Jzhoou/Lymphedema-Massager/模型/第二版建模sw文件/按摩环内装配体.SLDASM

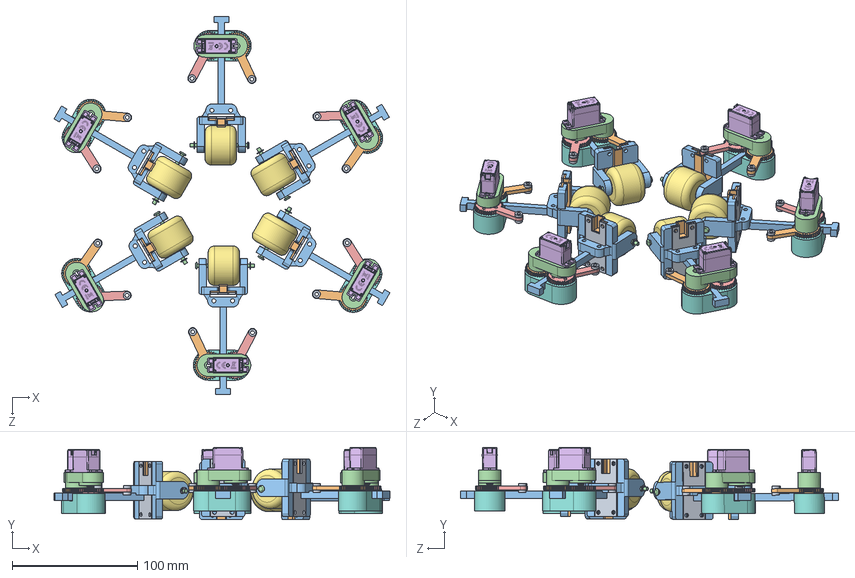
[picture p1: CAD file, 2026-10-14]
模型/第二版建模sw文件/按摩环内装配体.SLDASM
268.4 x 57.9 x 302.2 mm
DS1202三维图 x 6
主动齿轮 x 6
齿轮座盖1.0 x 6
按摩头连接件1.0 x 6
被动齿轮 x 6
滚动轴承 x 24
舵机盖 x 6
按摩头2.0 x 6
卡簧 x 6
微型轴承 x 12
轴销 x 6
柱塞 x 6
下盖sw x 6
上盖sw x 6
