Jzhoou/Lymphedema-Massager/模型/第二版建模sw文件/收纳盒.SLDASM

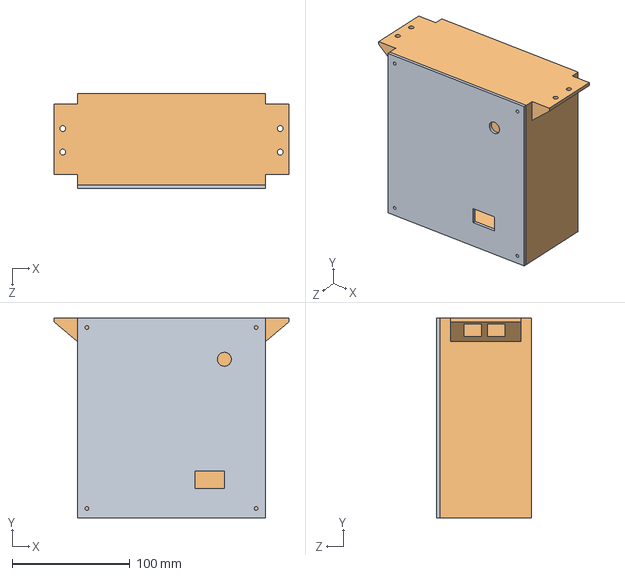
[picture p2: CAD file, 2026-10-14]
模型/第二版建模sw文件/收纳盒.SLDASM
200.0 x 170.0 x 81.0 mm
外壳1
外壳2
