Jzhoou/Lymphedema-Massager/模型/第二版建模sw文件/压力/压力传感器.SLDASM

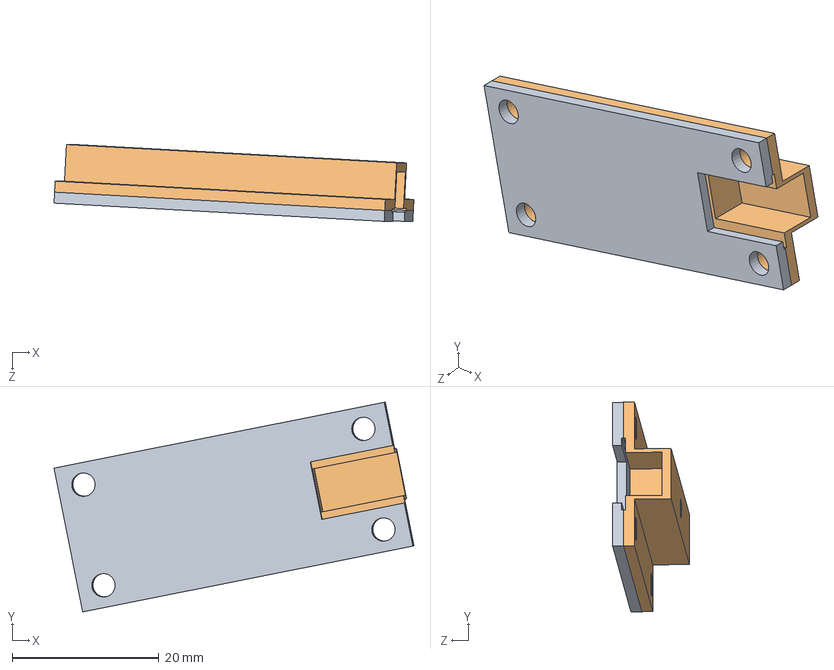
[picture p3: CAD file, 2026-10-14]
模型/第二版建模sw文件/压力/压力传感器.SLDASM
49.1 x 28.6 x 10.5 mm
柱塞
下盖sw
上盖sw
