Jzhoou/Lymphedema-Massager/模型/第二版建模sw文件/总装配体.SLDASM

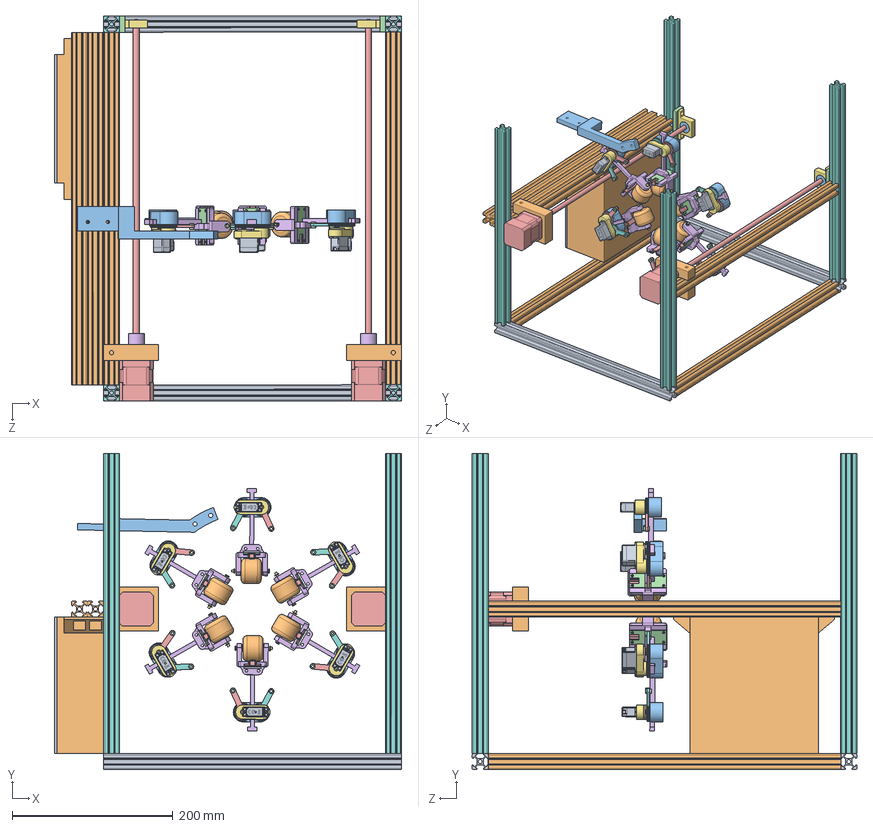
[picture p4: CAD file, 2026-10-14]
模型/第二版建模sw文件/总装配体.SLDASM
432.1 x 394.0 x 479.0 mm
铝型材43.9cm x 6
铝型材37.1cm x 2
铝型材37.4cm x 4
丝杆末端固定件 x 2
联轴器 x 2
丝杆电机 x 2
丝杆固定件座垫 x 2
丝杆末端固定件内端 x 2
电机固定件3.0 x 3
DS1202三维图 x 6
主动齿轮 x 6
齿轮座盖1.0 x 6
按摩头连接件1.0 x 6
被动齿轮 x 6
滚动轴承 x 24
舵机盖 x 6
按摩头2.0 x 6
卡簧 x 6
微型轴承 x 12
轴销 x 6
柱塞 x 6
下盖sw x 6
上盖sw x 6
工作台
外壳1
外壳2
