Jzhoou/Lymphedema-Massager/模型/第二版建模sw文件/外壳装配体.SLDASM

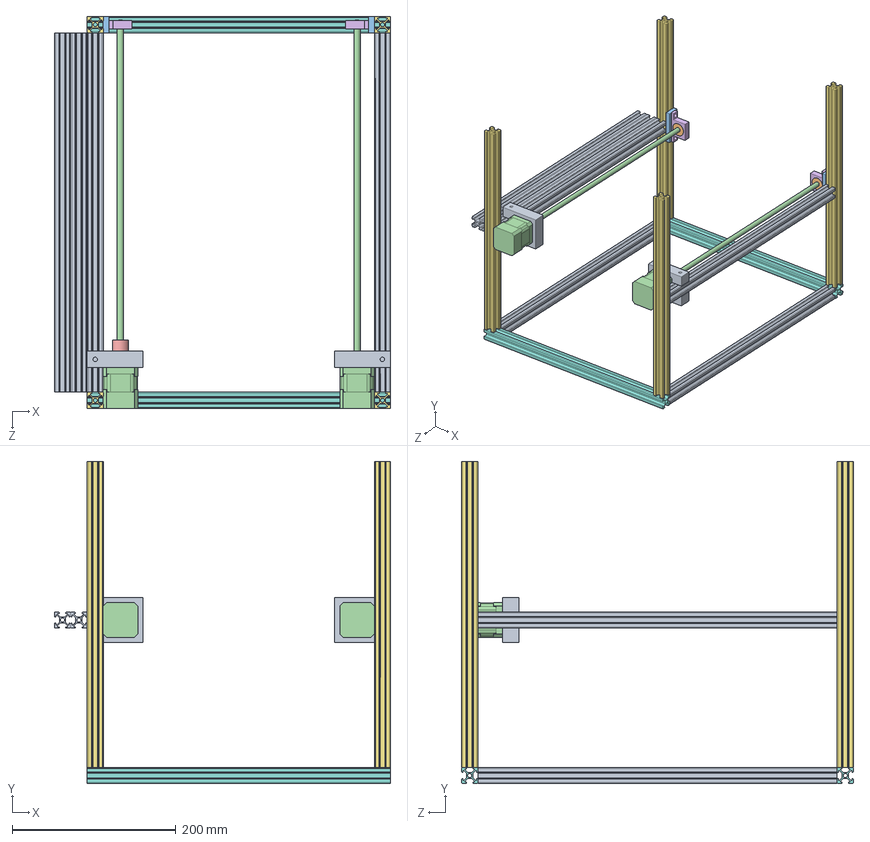
[picture p5: CAD file, 2026-10-14]
模型/第二版建模sw文件/外壳装配体.SLDASM
411.1 x 394.0 x 479.0 mm
铝型材43.9cm x 6
铝型材37.1cm x 2
铝型材37.4cm x 4
丝杆末端固定件 x 2
联轴器
丝杆电机 x 2
丝杆固定件座垫 x 2
丝杆末端固定件内端 x 2
电机固定件3.0 x 2
