Jzhoou/Lymphedema-Massager/模型/第二版建模sw文件/舵机按摩头装配体.SLDASM

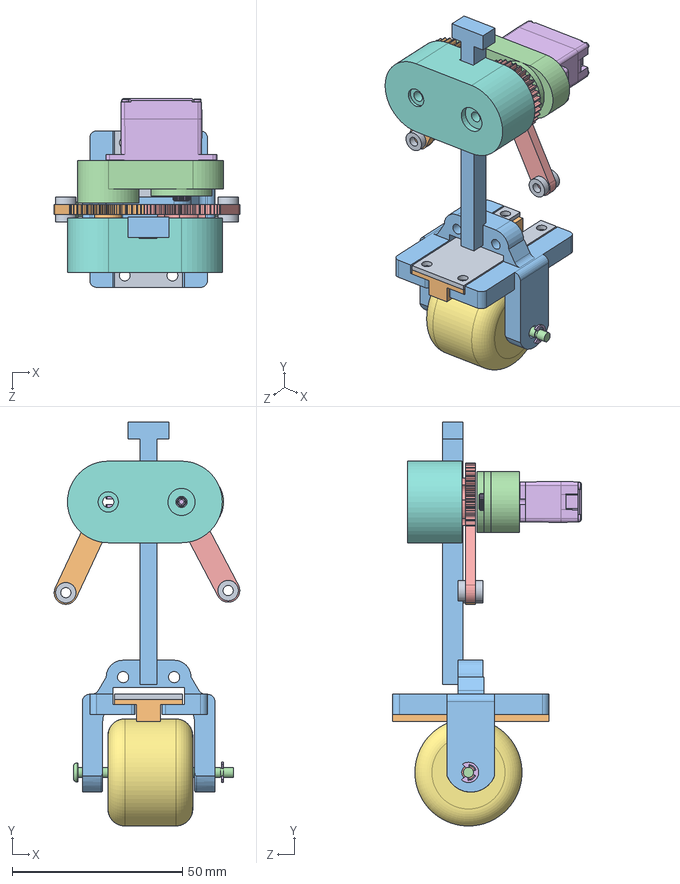
[picture p6: CAD file, 2026-10-14]
模型/第二版建模sw文件/舵机按摩头装配体.SLDASM
54.6 x 118.7 x 55.5 mm
DS1202三维图
主动齿轮
齿轮座盖1.0
按摩头连接件1.0
被动齿轮
滚动轴承 x 4
舵机盖
按摩头2.0
卡簧
微型轴承 x 2
轴销
柱塞
下盖sw
上盖sw
