Jzhoou/Lymphedema-Massager/上位机/measurement-perception-master/Upcomputer.UI/Resources/arm.STL

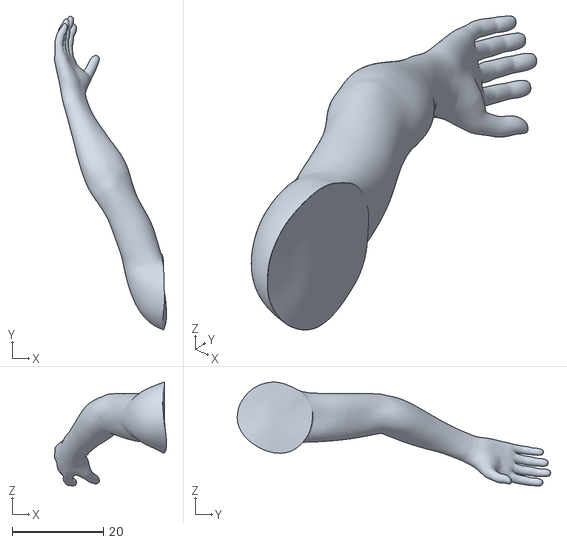
[picture p7: CAD file, 2026-06-20]
上位机/measurement-perception-master/Upcomputer.UI/Resources/arm.STL
24.5 x 68.7 x 22.7
