Jzhoou/Lymphedema-Massager/模型/第二版建模sw文件/压力/shuangzi2.stp

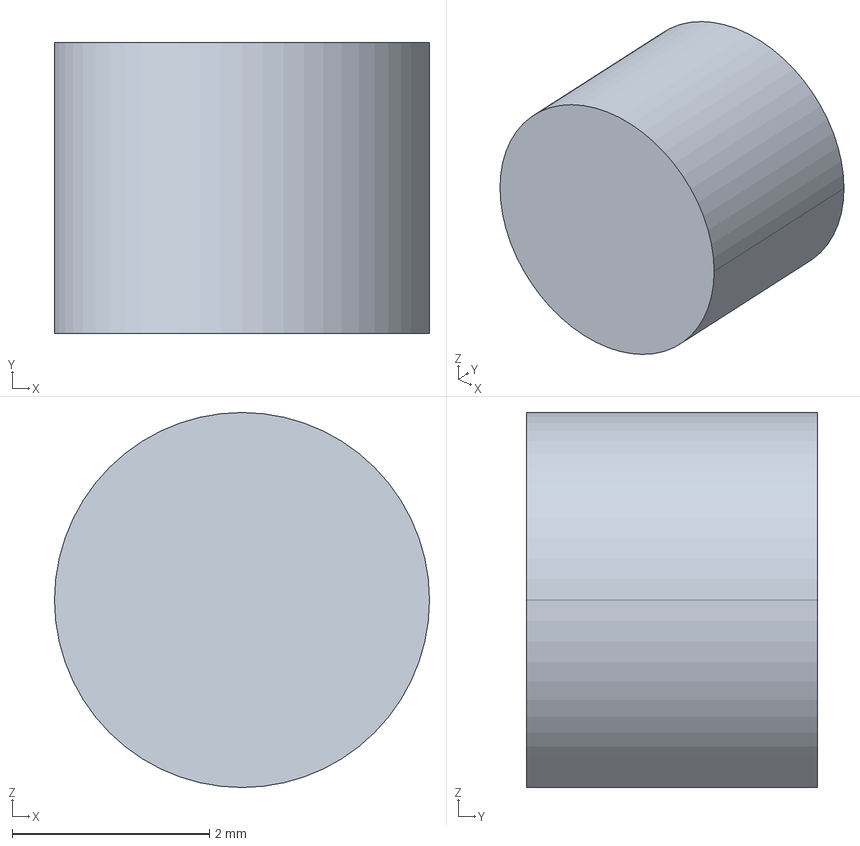
[picture p8: CAD file, 2026-10-14]
模型/第二版建模sw文件/压力/shuangzi2.stp
3.80 x 2.95 x 3.80 mm
