Jzhoou/Lymphedema-Massager/模型/第二版建模sw文件/压力/下盖.SLDPRT

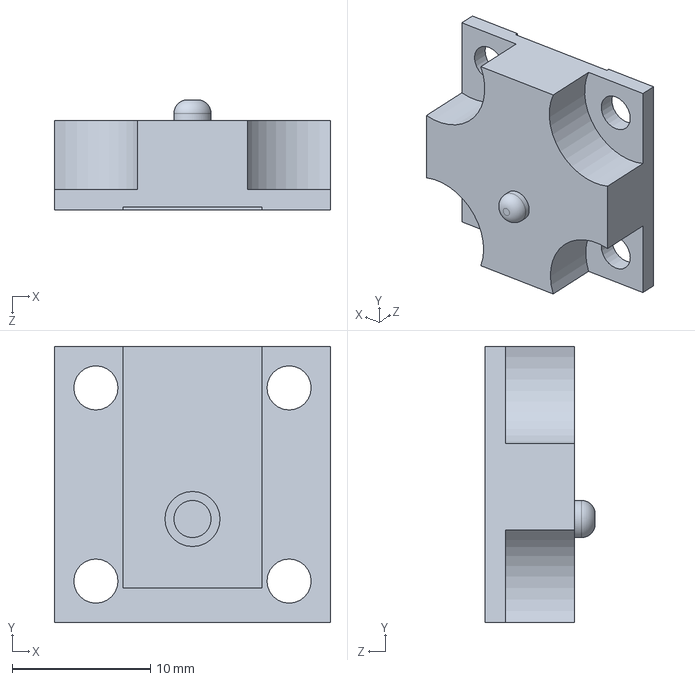
[picture p9: CAD file, 2026-10-14]
模型/第二版建模sw文件/压力/下盖.SLDPRT
20.0 x 20.0 x 8.00 mm
