Jzhoou/Lymphedema-Massager/模型/第二版建模sw文件/微型轴承.SLDPRT

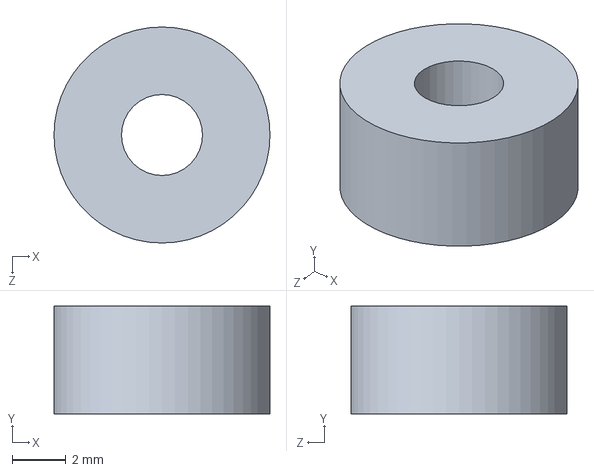
[picture p10: CAD file, 2026-10-14]
模型/第二版建模sw文件/微型轴承.SLDPRT
8.00 x 4.00 x 8.00 mm
