Jzhoou/Lymphedema-Massager/模型/第二版建模sw文件/丝杆固定件座垫.SLDPRT

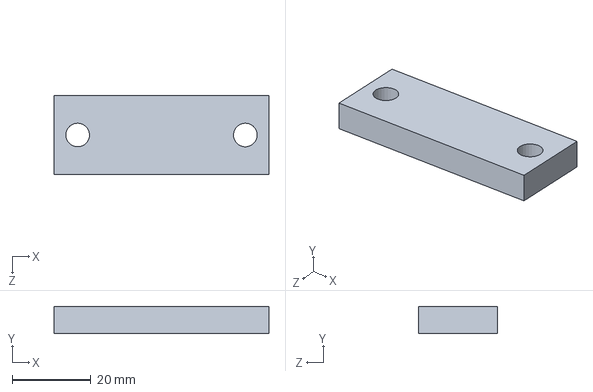
[picture p11: CAD file, 2026-10-14]
模型/第二版建模sw文件/丝杆固定件座垫.SLDPRT
54.5 x 6.85 x 20.0 mm
