Jzhoou/Lymphedema-Massager/模型/第二版建模sw文件/压力/上盖2.SLDPRT

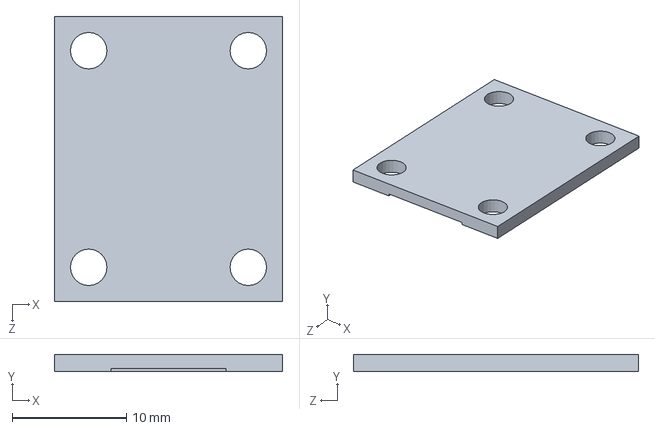
[picture p12: CAD file, 2026-10-14]
模型/第二版建模sw文件/压力/上盖2.SLDPRT
20.0 x 1.50 x 25.0 mm
