Jzhoou/Lymphedema-Massager/模型/第二版建模sw文件/压力/下盖sw.SLDPRT

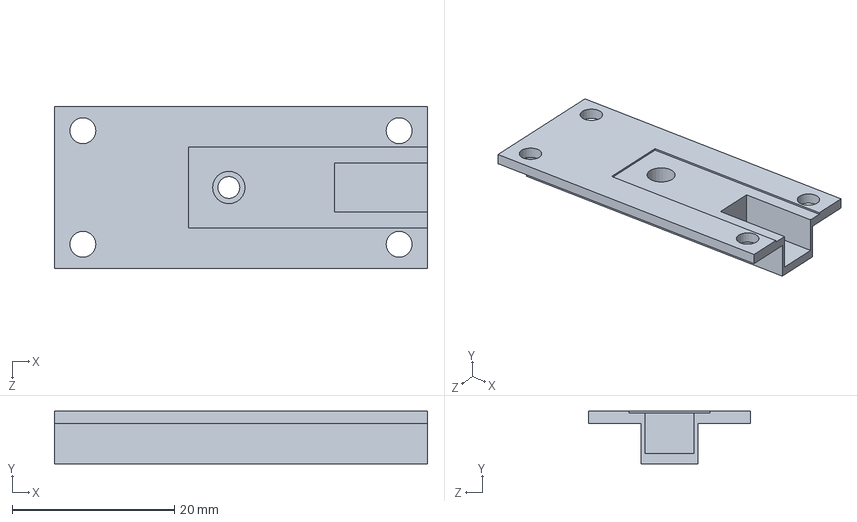
[picture p13: CAD file, 2026-10-14]
模型/第二版建模sw文件/压力/下盖sw.SLDPRT
46.0 x 6.50 x 20.0 mm
