Jzhoou/Lymphedema-Massager/模型/第二版建模sw文件/压力/下盖1.SLDPRT

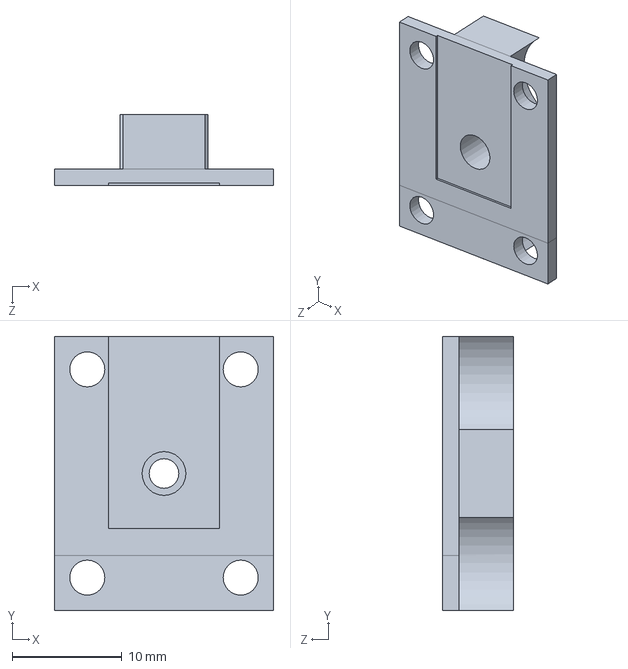
[picture p14: CAD file, 2026-10-14]
模型/第二版建模sw文件/压力/下盖1.SLDPRT
20.0 x 25.0 x 6.50 mm
