Jzhoou/Lymphedema-Massager/模型/第二版建模sw文件/垫片.SLDPRT

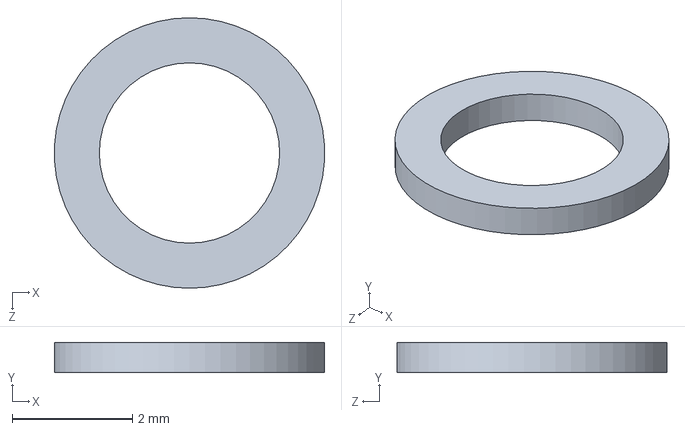
[picture p15: CAD file, 2026-10-14]
模型/第二版建模sw文件/垫片.SLDPRT
4.49 x 0.5 x 4.50 mm
