Jzhoou/Lymphedema-Massager/模型/第二版建模sw文件/按摩头打印版2.0凸.SLDPRT

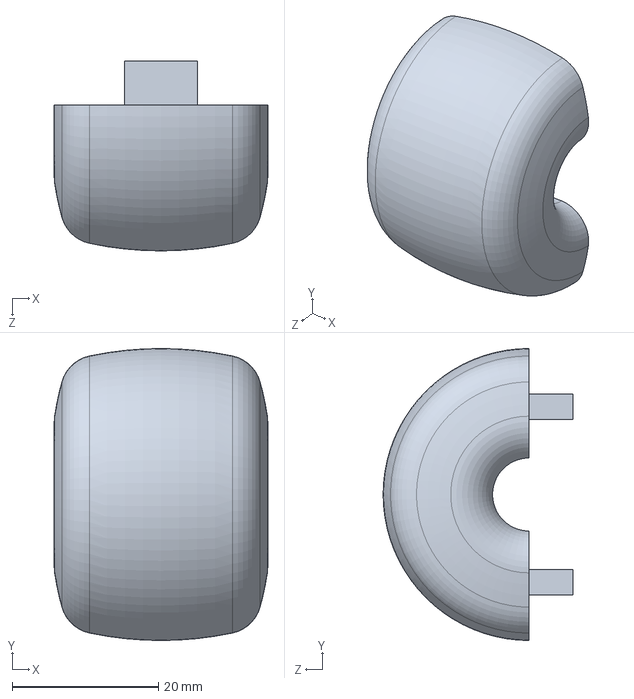
[picture p16: CAD file, 2026-10-14]
模型/第二版建模sw文件/按摩头打印版2.0凸.SLDPRT
29.3 x 40.0 x 26.0 mm
