Jzhoou/Lymphedema-Massager/模型/第二版建模sw文件/DS1202三维图.SLDPRT

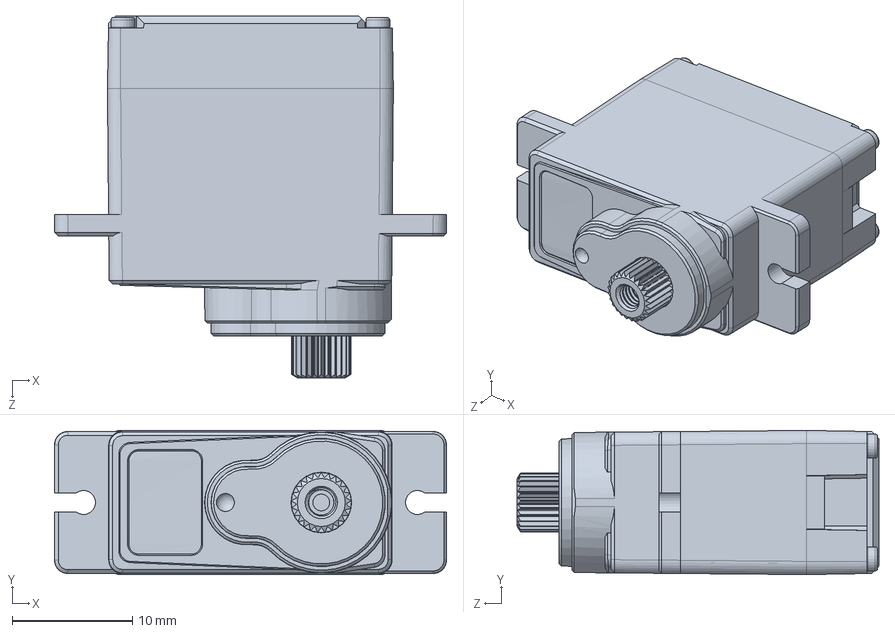
[picture p17: CAD file, 2026-10-14]
模型/第二版建模sw文件/DS1202三维图.SLDPRT
32.6 x 12.0 x 30.1 mm
