Jzhoou/Lymphedema-Massager/模型/第二版建模sw文件/压力/xiabufen4(1).stp

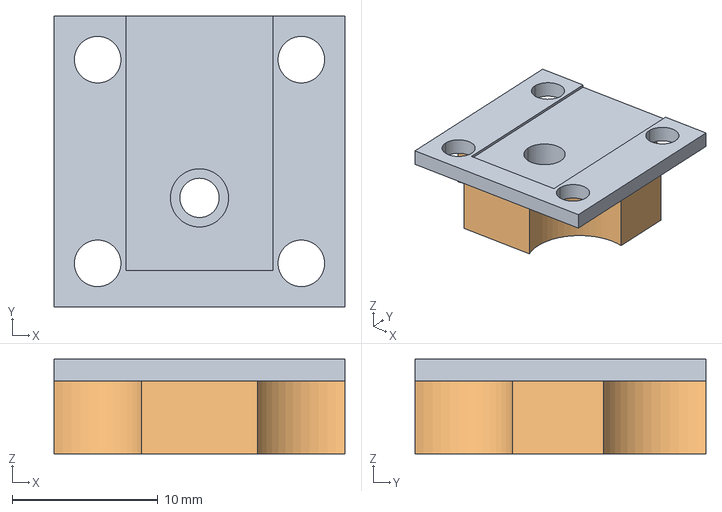
[picture p18: CAD file, 2026-10-14]
模型/第二版建模sw文件/压力/xiabufen4(1).stp
20.0 x 20.0 x 6.50 mm
