Jzhoou/Lymphedema-Massager/模型/第二版建模sw文件/按摩头2.0.SLDPRT

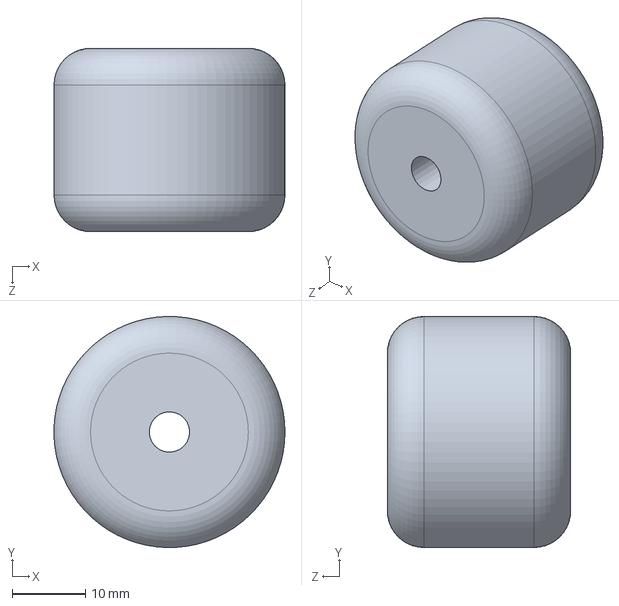
[picture p19: CAD file, 2026-10-14]
模型/第二版建模sw文件/按摩头2.0.SLDPRT
31.5 x 31.5 x 25.0 mm
