Jzhoou/Lymphedema-Massager/模型/第二版建模sw文件/舵机盖.SLDPRT

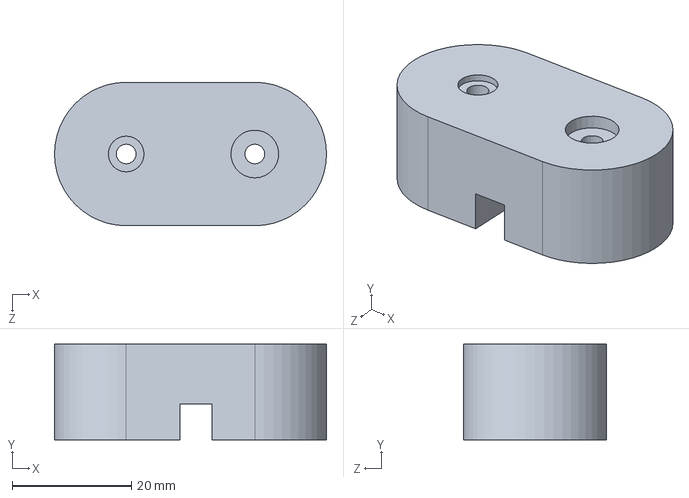
[picture p20: CAD file, 2026-10-14]
模型/第二版建模sw文件/舵机盖.SLDPRT
45.5 x 16.0 x 24.0 mm
