Jzhoou/Lymphedema-Massager/模型/第二版建模sw文件/压力/上盖sw.SLDPRT

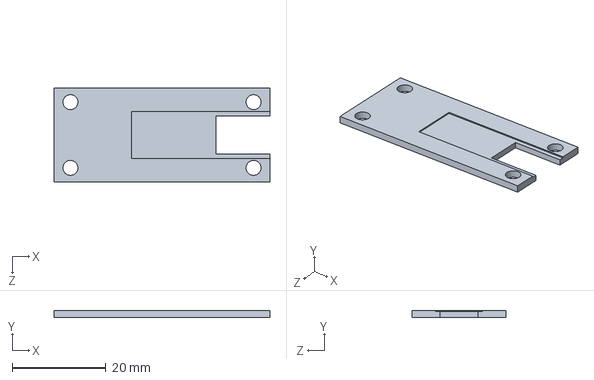
[picture p21: CAD file, 2026-10-14]
模型/第二版建模sw文件/压力/上盖sw.SLDPRT
46.0 x 1.50 x 20.0 mm
