Jzhoou/Lymphedema-Massager/模型/第二版建模sw文件/卡簧.SLDPRT

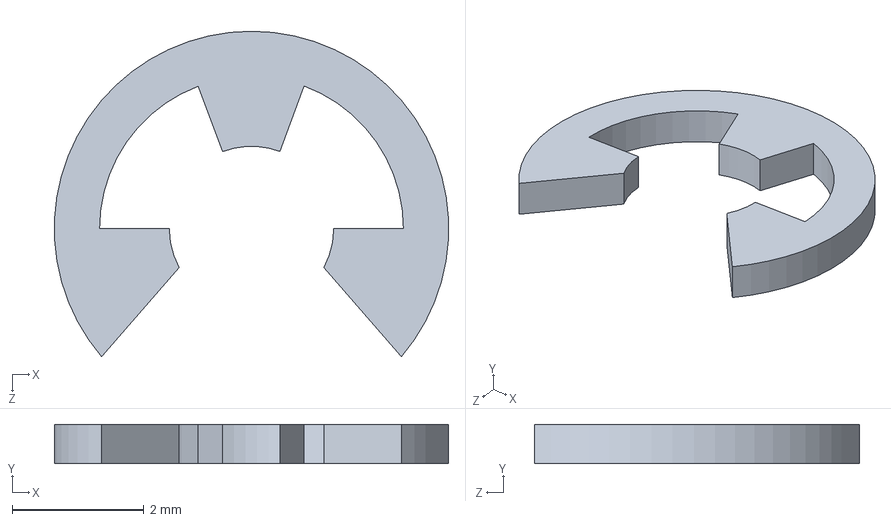
[picture p22: CAD file, 2026-10-14]
模型/第二版建模sw文件/卡簧.SLDPRT
5.99 x 0.6 x 4.95 mm
