Jzhoou/Lymphedema-Massager/模型/第二版建模sw文件/压力/柱塞sw.SLDPRT

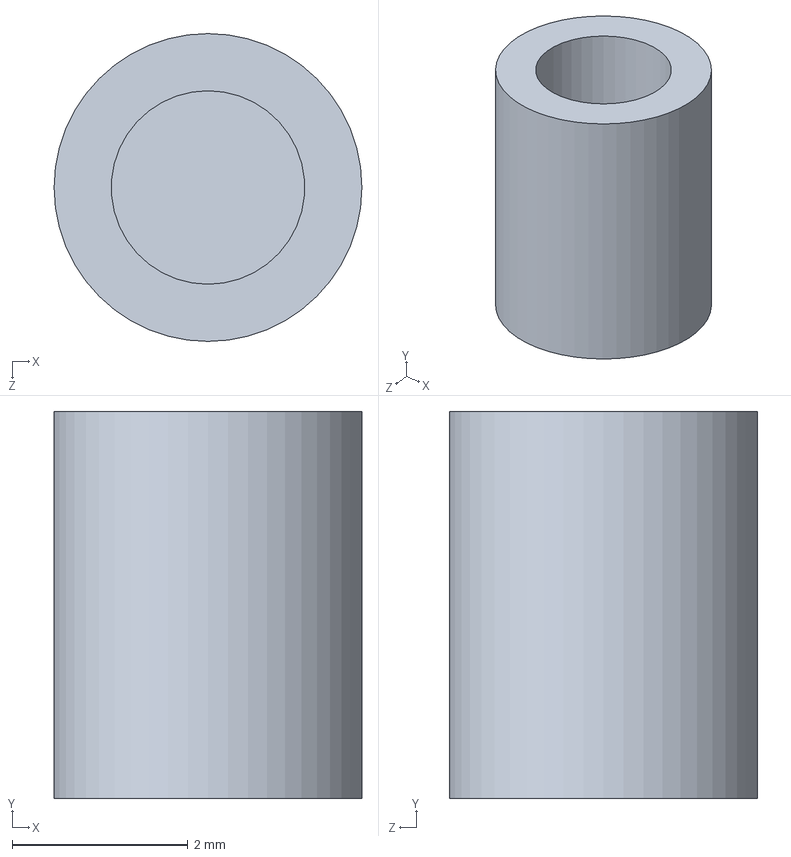
[picture p23: CAD file, 2026-10-14]
模型/第二版建模sw文件/压力/柱塞sw.SLDPRT
3.50 x 4.40 x 3.50 mm
