Jzhoou/Lymphedema-Massager/模型/第二版建模sw文件/压力/shangbufen.stp

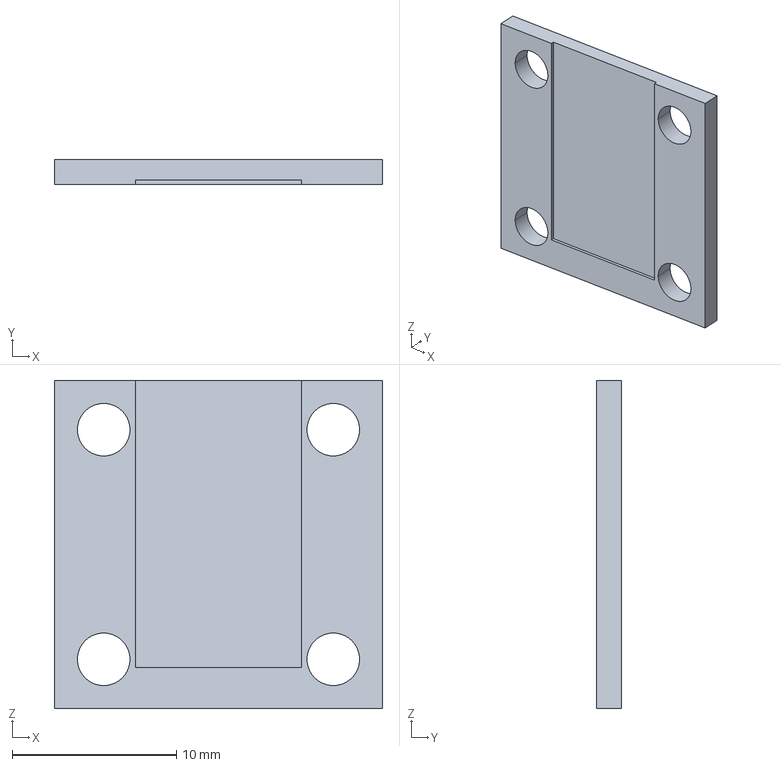
[picture p24: CAD file, 2026-10-14]
模型/第二版建模sw文件/压力/shangbufen.stp
20.0 x 1.50 x 20.0 mm
