Jzhoou/Lymphedema-Massager/模型/第二版建模sw文件/工作台.SLDPRT

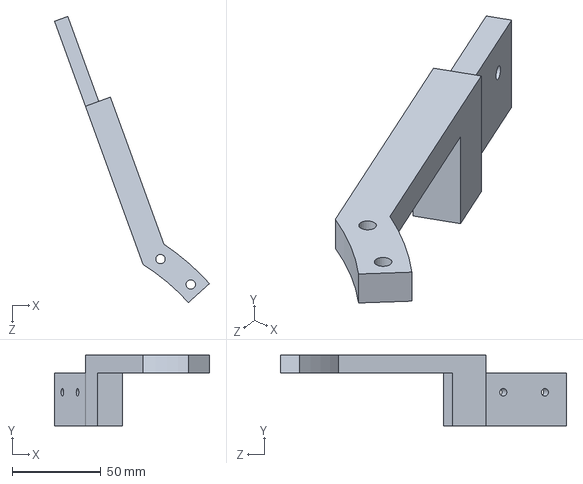
[picture p25: CAD file, 2026-10-14]
模型/第二版建模sw文件/工作台.SLDPRT
87.4 x 40.0 x 161.4 mm
