Jzhoou/Lymphedema-Massager/模型/第二版建模sw文件/铝型材37.1cm.SLDPRT

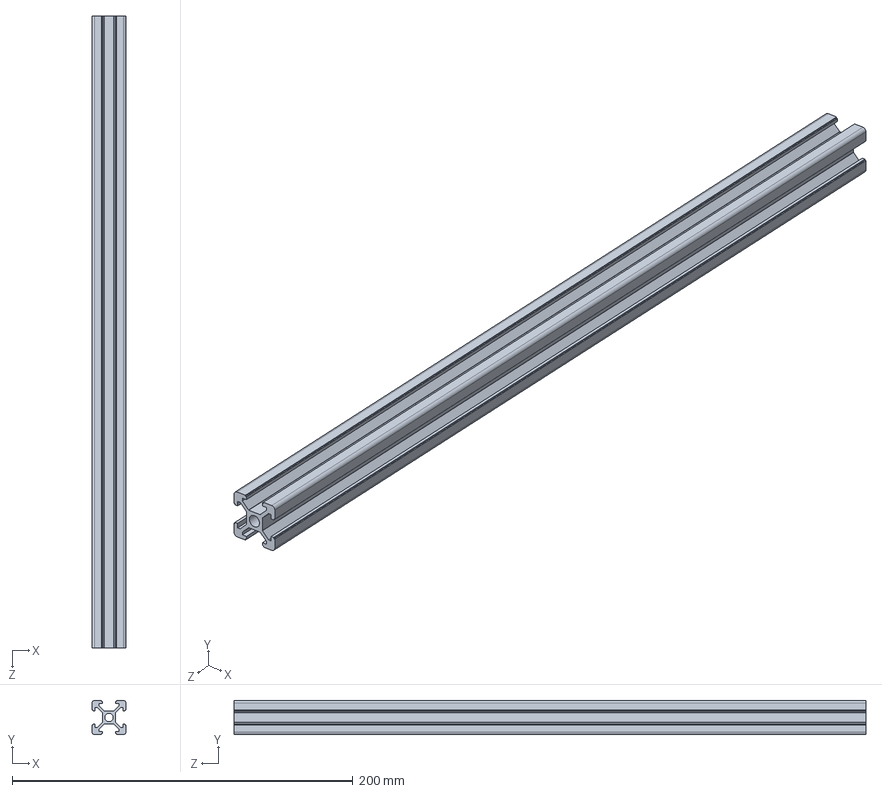
[picture p26: CAD file, 2026-10-14]
模型/第二版建模sw文件/铝型材37.1cm.SLDPRT
20.0 x 20.0 x 371.0 mm
