Jzhoou/Lymphedema-Massager/模型/第二版建模sw文件/压力/上盖.SLDPRT

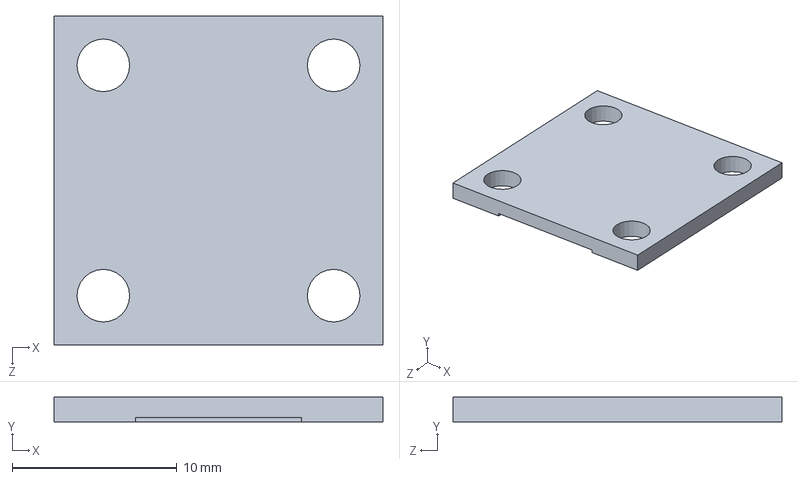
[picture p27: CAD file, 2026-10-14]
模型/第二版建模sw文件/压力/上盖.SLDPRT
20.0 x 1.50 x 20.0 mm
