Jzhoou/Lymphedema-Massager/模型/第二版建模sw文件/挡片2.SLDPRT

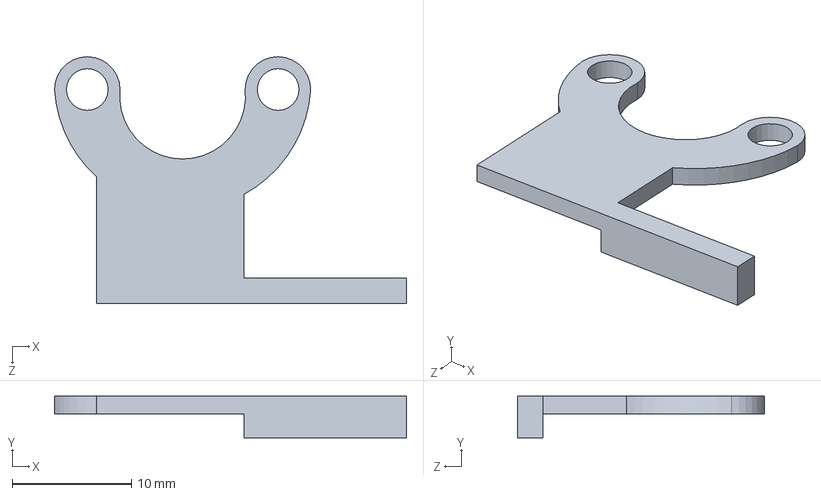
[picture p28: CAD file, 2026-10-14]
模型/第二版建模sw文件/挡片2.SLDPRT
29.5 x 3.50 x 20.7 mm
