Jzhoou/Lymphedema-Massager/模型/第二版建模sw文件/丝杆末端固定件.SLDPRT

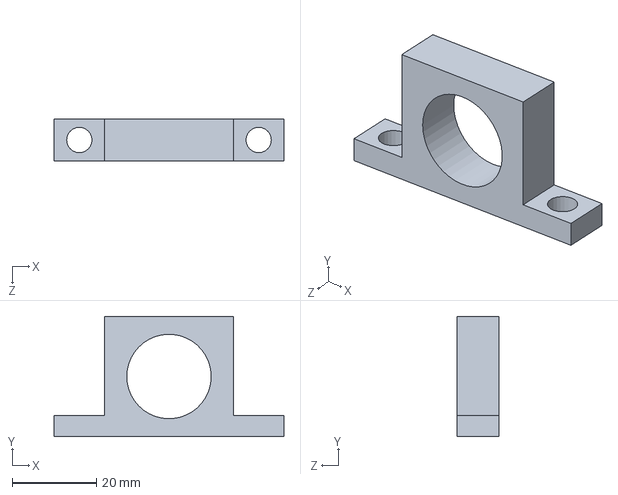
[picture p29: CAD file, 2026-10-14]
模型/第二版建模sw文件/丝杆末端固定件.SLDPRT
54.5 x 28.5 x 10.0 mm
