Jzhoou/Lymphedema-Massager/模型/第二版建模sw文件/电机固定件3.0.SLDPRT

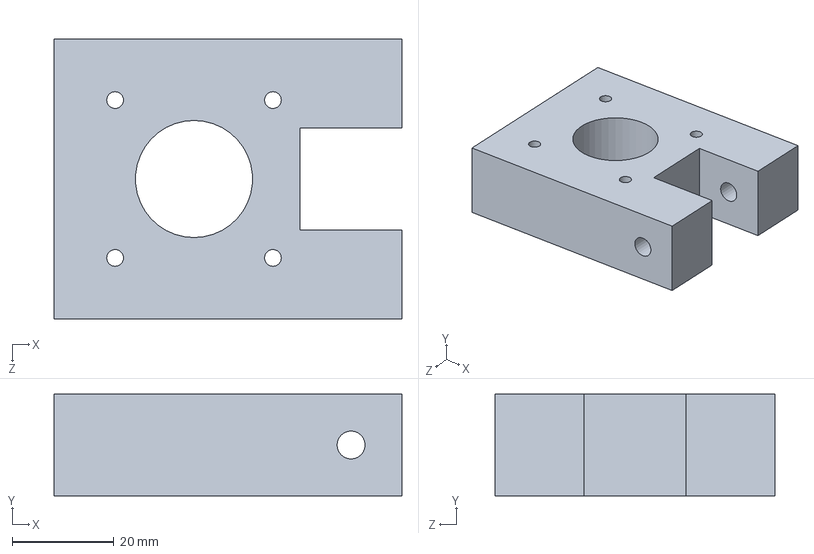
[picture p30: CAD file, 2026-10-14]
模型/第二版建模sw文件/电机固定件3.0.SLDPRT
68.3 x 20.0 x 55.0 mm
