Jzhoou/Lymphedema-Massager/模型/第二版建模sw文件/丝杆末端固定件内端.SLDPRT

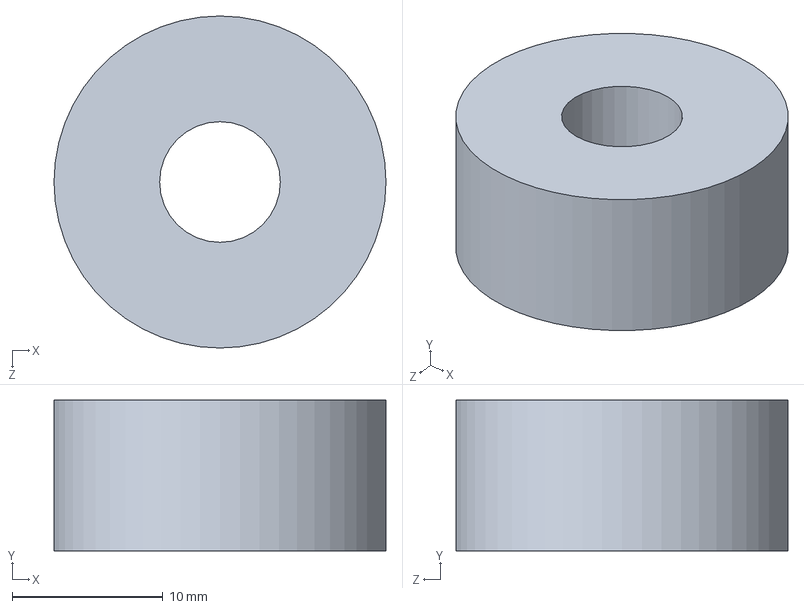
[picture p31: CAD file, 2026-10-14]
模型/第二版建模sw文件/丝杆末端固定件内端.SLDPRT
22.0 x 10.0 x 22.0 mm
