Jzhoou/Lymphedema-Massager/模型/第二版建模sw文件/主动齿轮.SLDPRT

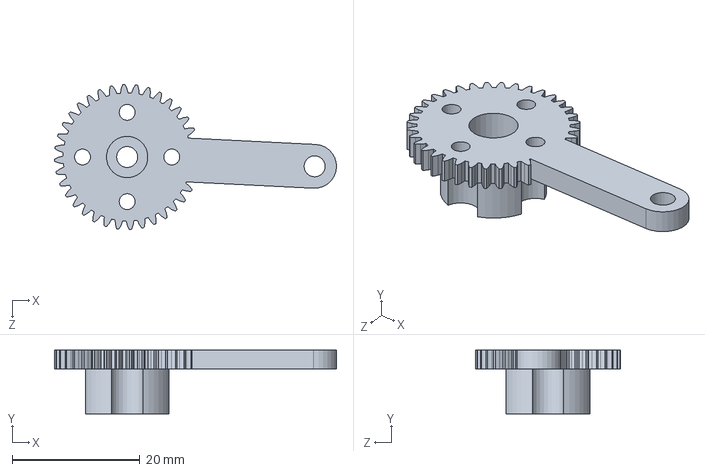
[picture p32: CAD file, 2026-10-14]
模型/第二版建模sw文件/主动齿轮.SLDPRT
44.2 x 10.0 x 22.8 mm
