Jzhoou/Lymphedema-Massager/模型/第二版建模sw文件/丝杆.SLDPRT

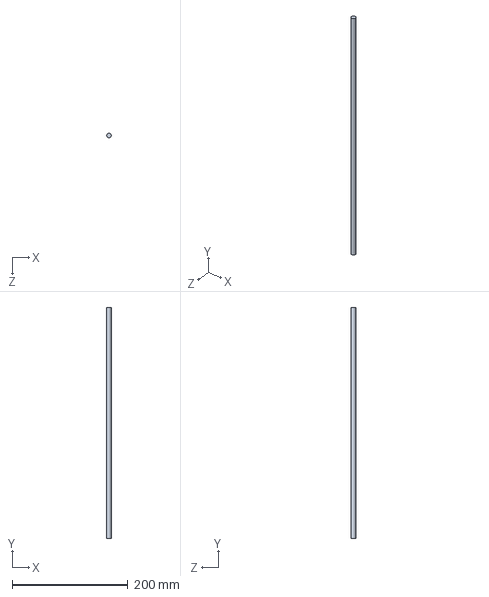
[picture p33: CAD file, 2026-10-14]
模型/第二版建模sw文件/丝杆.SLDPRT
8.00 x 400.0 x 8.00 mm
