Jzhoou/Lymphedema-Massager/模型/第二版建模sw文件/轴销.SLDPRT

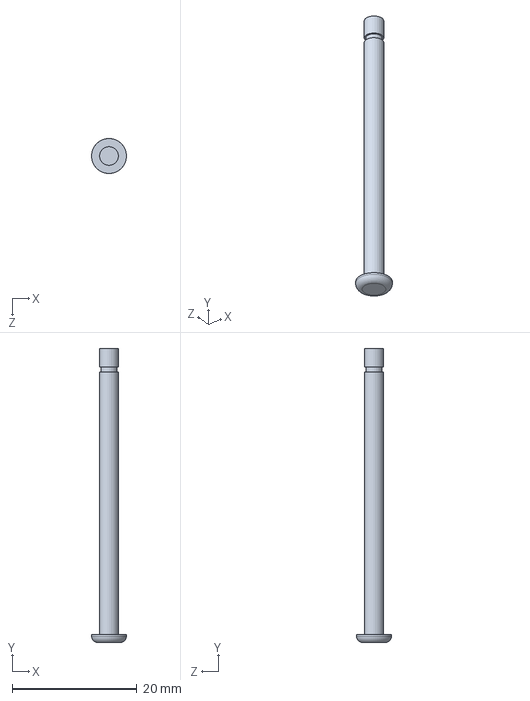
[picture p34: CAD file, 2026-10-14]
模型/第二版建模sw文件/轴销.SLDPRT
5.60 x 47.1 x 5.60 mm
