Jzhoou/Lymphedema-Massager/模型/第二版建模sw文件/联轴器.SLDPRT

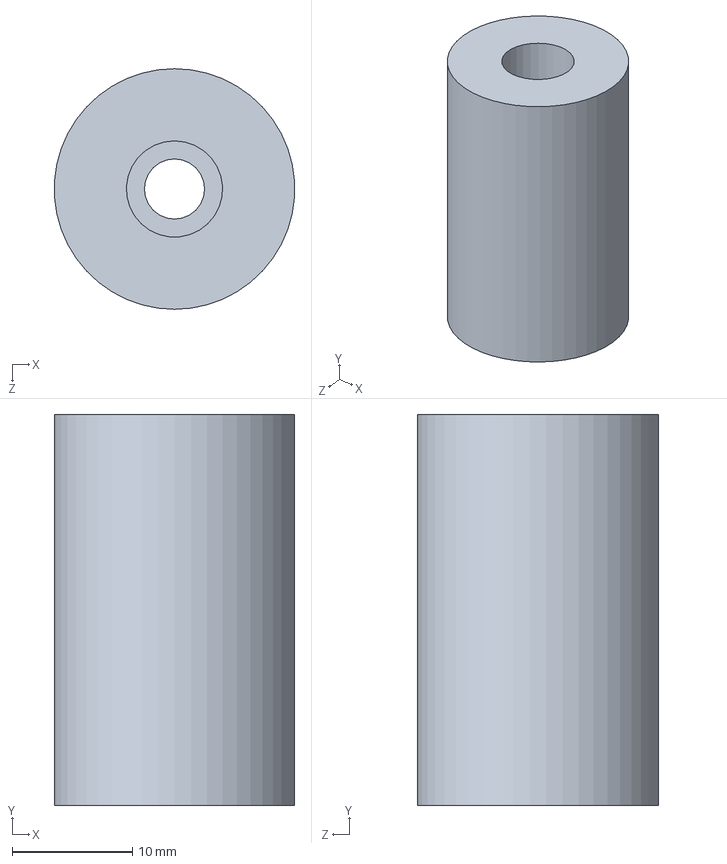
[picture p35: CAD file, 2026-10-14]
模型/第二版建模sw文件/联轴器.SLDPRT
20.0 x 32.5 x 20.0 mm
