Jzhoou/Lymphedema-Massager/模型/第二版建模sw文件/光杆.SLDPRT

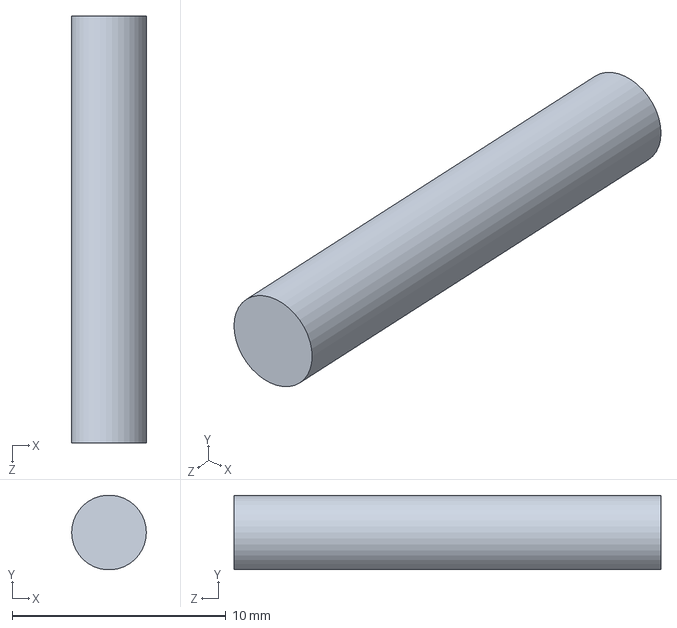
[picture p36: CAD file, 2026-10-14]
模型/第二版建模sw文件/光杆.SLDPRT
3.50 x 3.49 x 20.0 mm
