Jzhoou/Lymphedema-Massager/模型/第二版建模sw文件/外壳1.SLDPRT

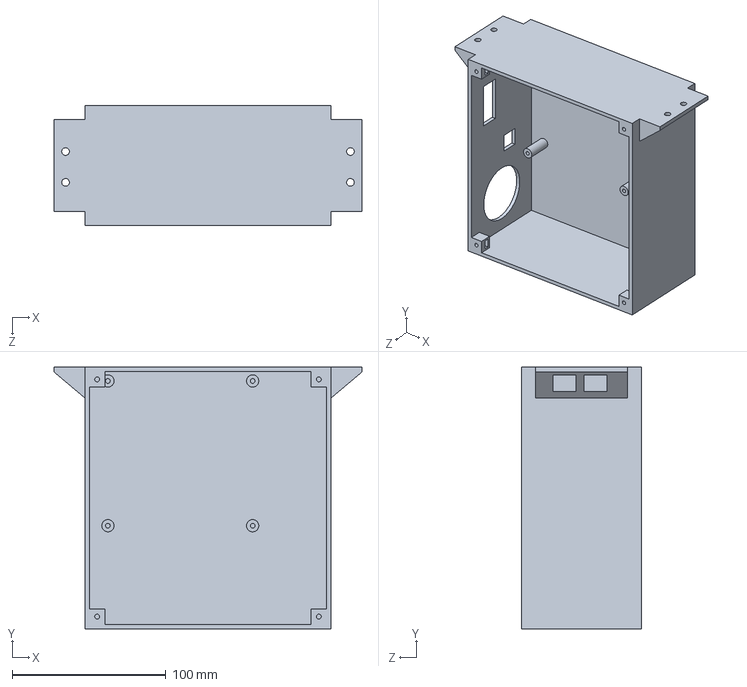
[picture p37: CAD file, 2026-10-14]
模型/第二版建模sw文件/外壳1.SLDPRT
200.0 x 170.0 x 78.0 mm
