Jzhoou/Lymphedema-Massager/模型/第二版建模sw文件/被动齿轮.SLDPRT

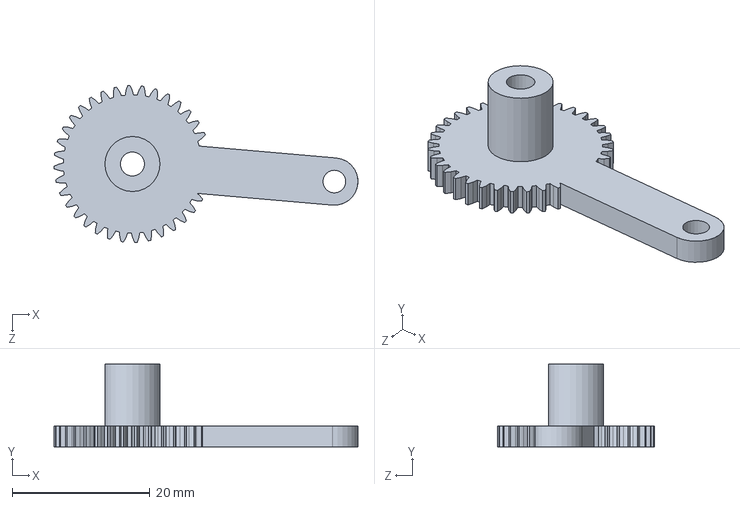
[picture p38: CAD file, 2026-10-14]
模型/第二版建模sw文件/被动齿轮.SLDPRT
44.2 x 12.0 x 22.8 mm
