Jzhoou/Lymphedema-Massager/模型/第二版建模sw文件/丝杆电机.SLDPRT

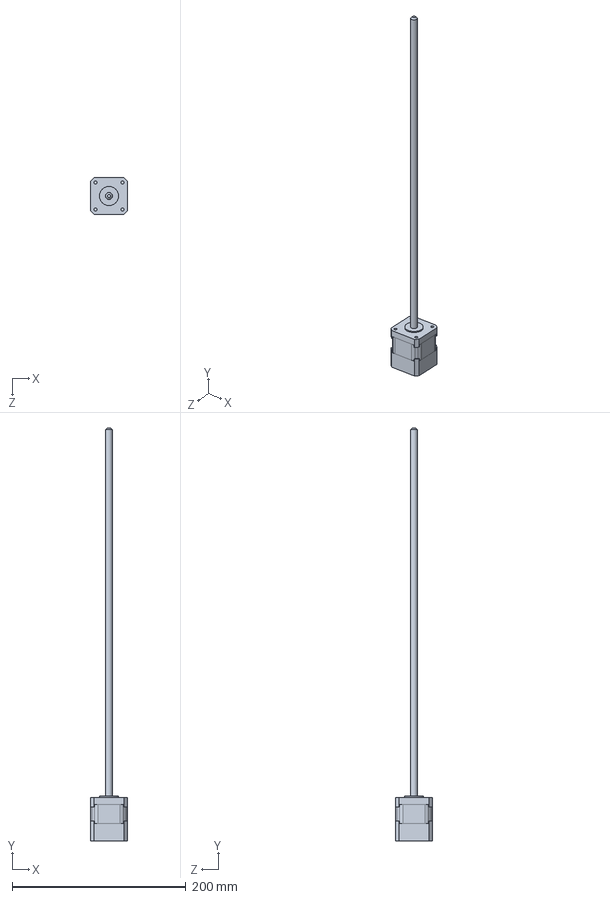
[picture p39: CAD file, 2026-10-14]
模型/第二版建模sw文件/丝杆电机.SLDPRT
42.3 x 475.0 x 42.3 mm
