Jzhoou/Lymphedema-Massager/模型/第二版建模sw文件/舵机轴承.SLDPRT

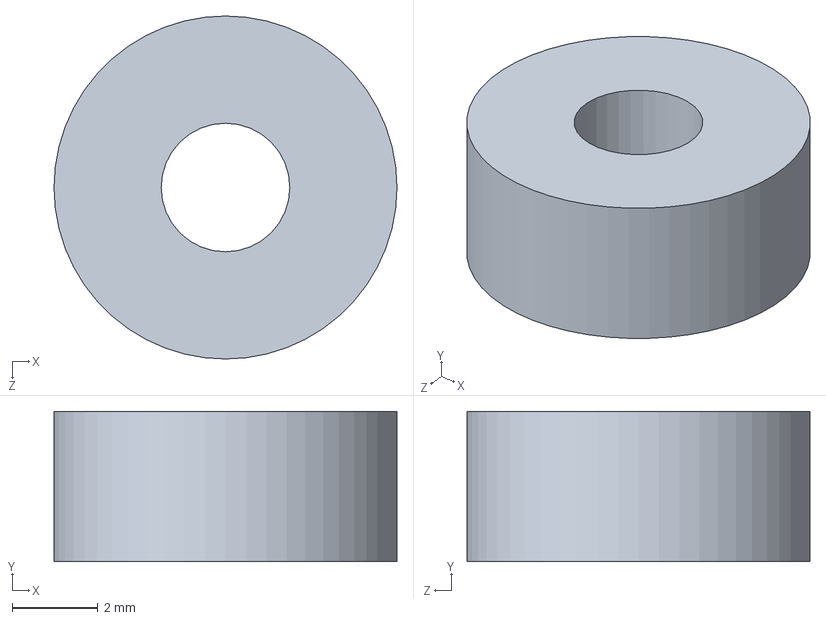
[picture p40: CAD file, 2026-10-14]
模型/第二版建模sw文件/舵机轴承.SLDPRT
8.00 x 3.50 x 8.00 mm
