Jzhoou/Lymphedema-Massager/模型/第二版建模sw文件/按摩头打印版2.0凹.SLDPRT

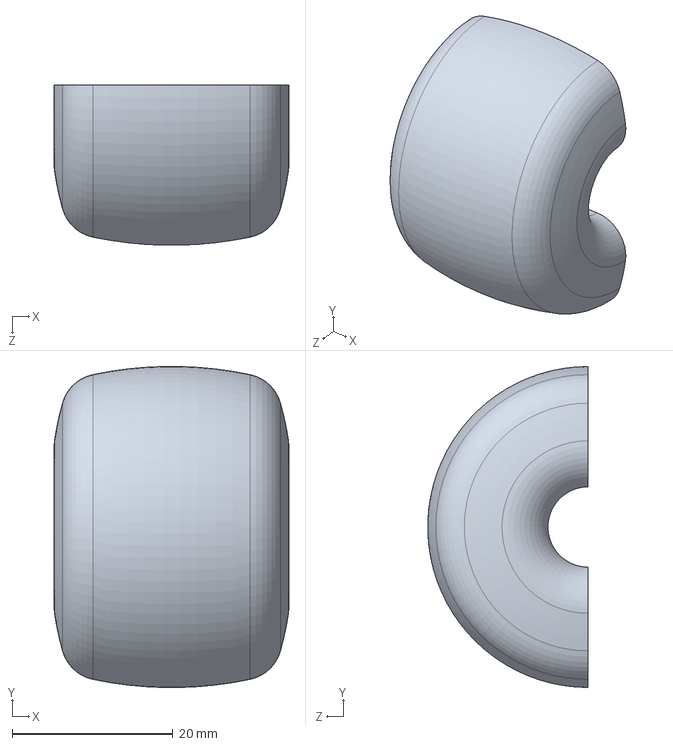
[picture p41: CAD file, 2026-10-14]
模型/第二版建模sw文件/按摩头打印版2.0凹.SLDPRT
29.3 x 40.0 x 20.0 mm
