Jzhoou/Lymphedema-Massager/模型/第二版建模sw文件/螺母.SLDPRT

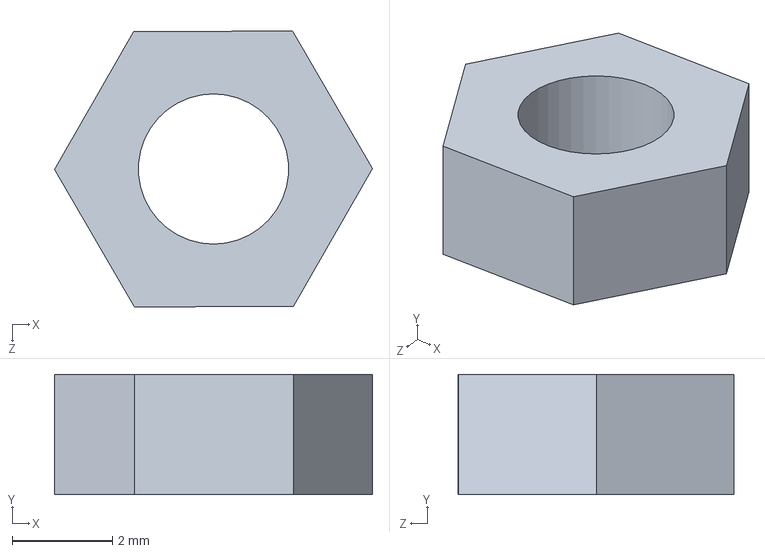
[picture p42: CAD file, 2026-10-14]
模型/第二版建模sw文件/螺母.SLDPRT
6.35 x 2.40 x 5.51 mm
