Jzhoou/Lymphedema-Massager/模型/第二版建模sw文件/铝型材37.4cm.SLDPRT

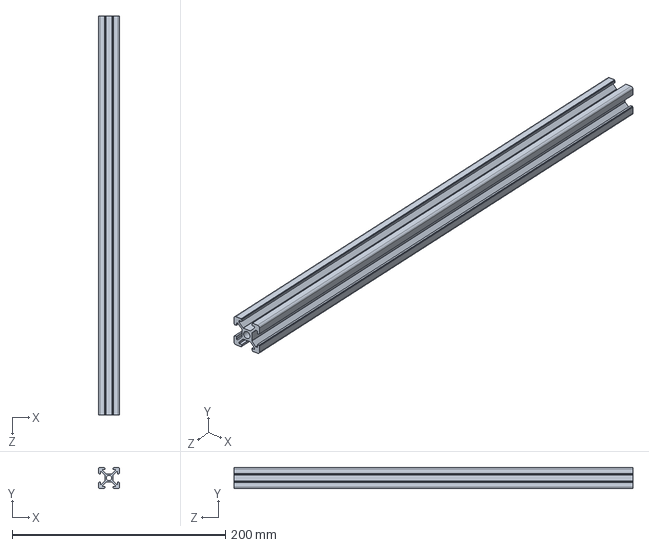
[picture p43: CAD file, 2026-10-14]
模型/第二版建模sw文件/铝型材37.4cm.SLDPRT
20.0 x 20.0 x 374.0 mm
