Jzhoou/Lymphedema-Massager/模型/第二版建模sw文件/铝型材43.9cm.SLDPRT

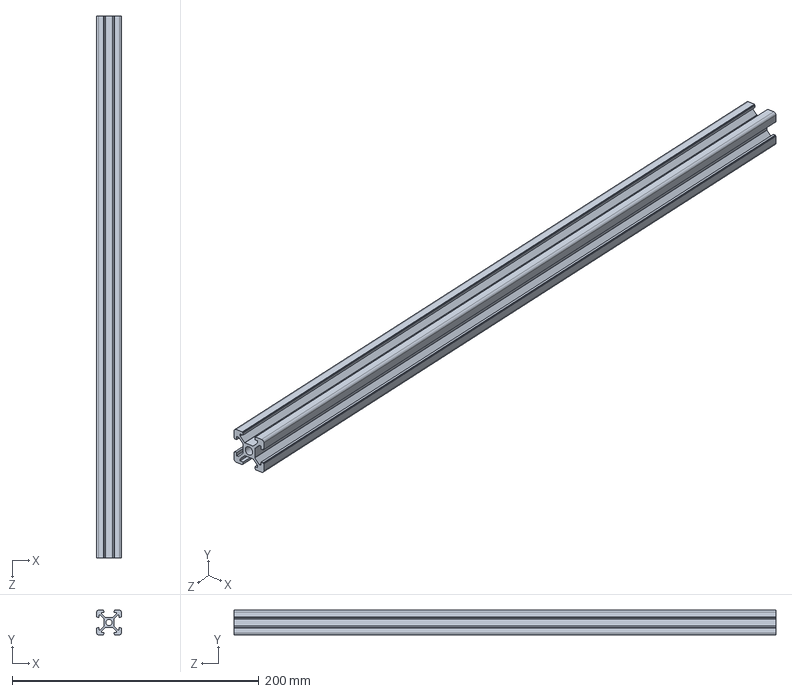
[picture p44: CAD file, 2026-10-14]
模型/第二版建模sw文件/铝型材43.9cm.SLDPRT
20.0 x 20.0 x 439.0 mm
