Jzhoou/Lymphedema-Massager/模型/第二版建模sw文件/按摩头连接件1.0.SLDPRT

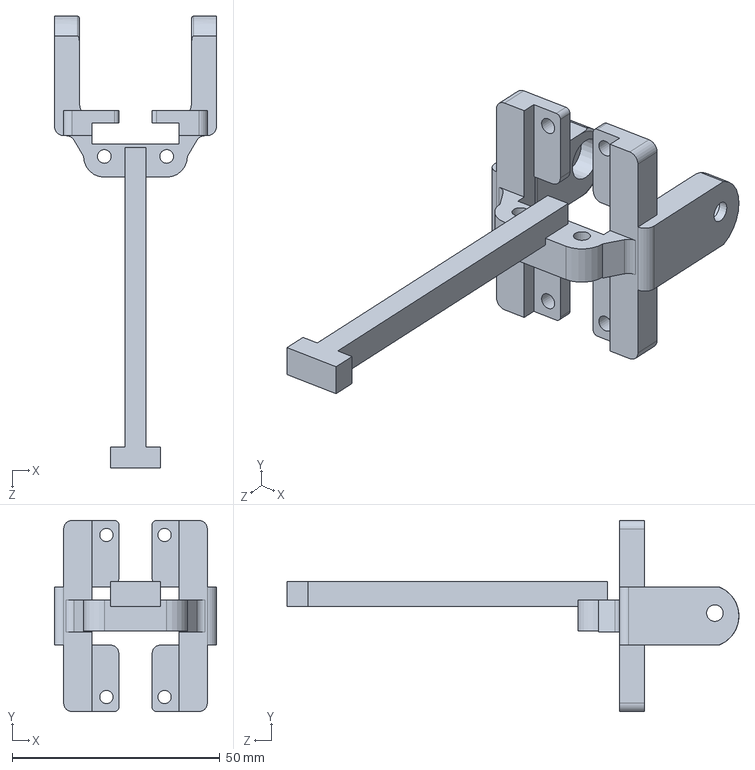
[picture p45: CAD file, 2026-10-14]
模型/第二版建模sw文件/按摩头连接件1.0.SLDPRT
39.0 x 46.0 x 108.8 mm
