Jzhoou/Lymphedema-Massager/模型/第二版建模sw文件/滚动轴承.SLDPRT

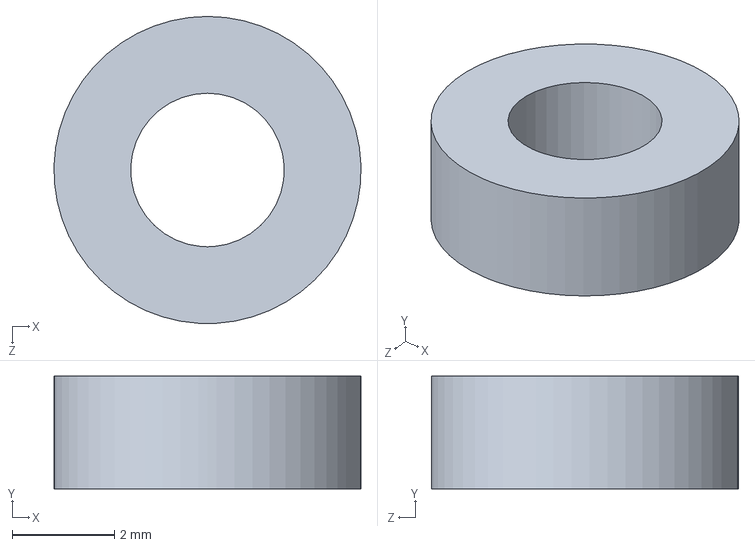
[picture p46: CAD file, 2026-10-14]
模型/第二版建模sw文件/滚动轴承.SLDPRT
6.00 x 2.20 x 6.00 mm
