Jzhoou/Lymphedema-Massager/模型/第二版建模sw文件/齿轮座盖1.0.SLDPRT

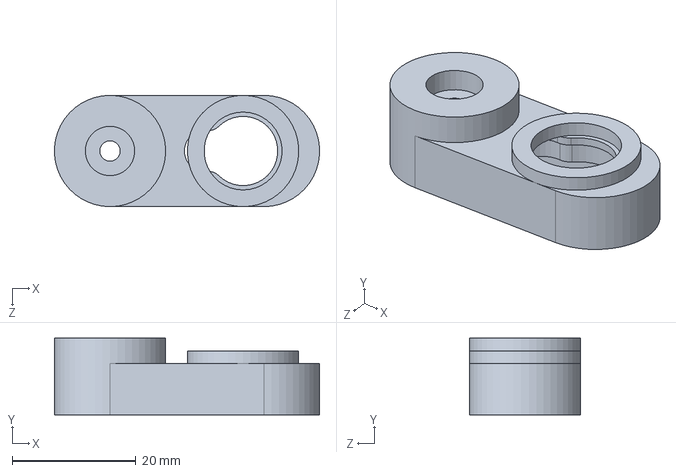
[picture p47: CAD file, 2026-10-14]
模型/第二版建模sw文件/齿轮座盖1.0.SLDPRT
42.9 x 12.4 x 18.0 mm
