Jzhoou/Lymphedema-Massager/模型/第二版建模sw文件/外壳2.SLDPRT

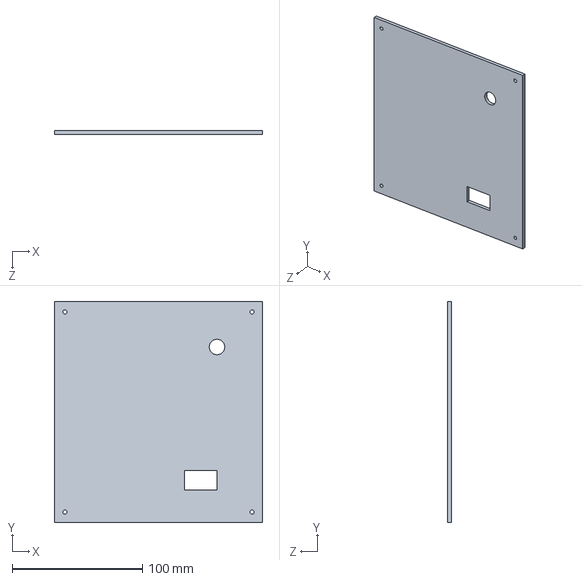
[picture p48: CAD file, 2026-10-14]
模型/第二版建模sw文件/外壳2.SLDPRT
160.0 x 170.0 x 3.00 mm
