Jzhoou/Lymphedema-Massager/模型/第二版建模sw文件/ZDT_X42_L40Motor.SLDPRT

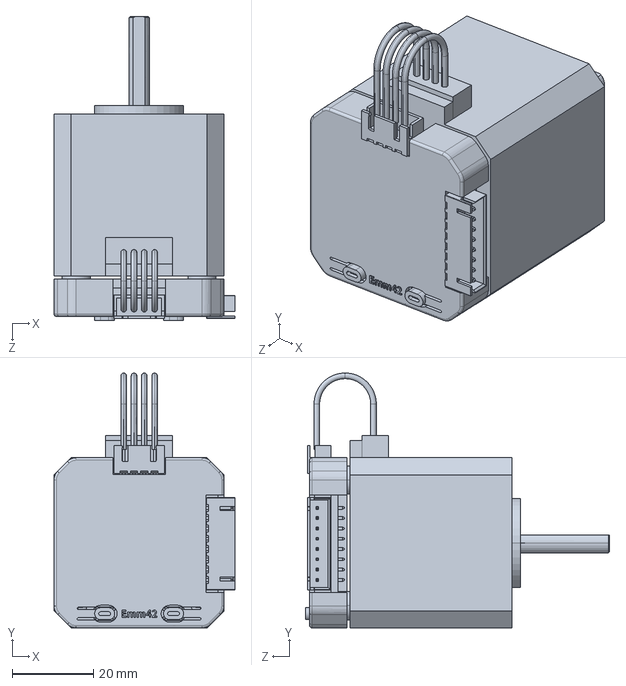
[picture p49: CAD file, 2026-10-14]
模型/第二版建模sw文件/ZDT_X42_L40Motor.SLDPRT
44.7 x 62.9 x 75.0 mm
