Jzhoou/Lymphedema-Massager/模型/第二版建模sw文件/按摩圈3.0.SLDPRT

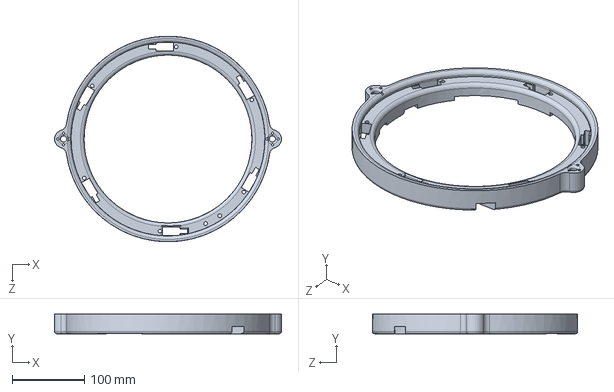
[picture p50: CAD file, 2026-10-14]
模型/第二版建模sw文件/按摩圈3.0.SLDPRT
313.8 x 27.0 x 284.0 mm
