Jzhoou/Lymphedema-Massager/模型/第二版建模sw文件/铝型材17cm.SLDPRT

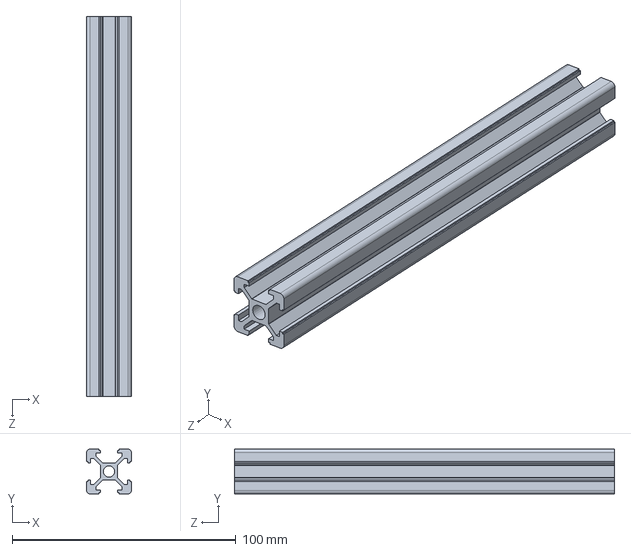
[picture p51: CAD file, 2026-10-14]
模型/第二版建模sw文件/铝型材17cm.SLDPRT
20.0 x 20.0 x 170.0 mm
