Jzhoou/Lymphedema-Massager/模型/第二版建模sw文件/丝杆法兰.SLDPRT

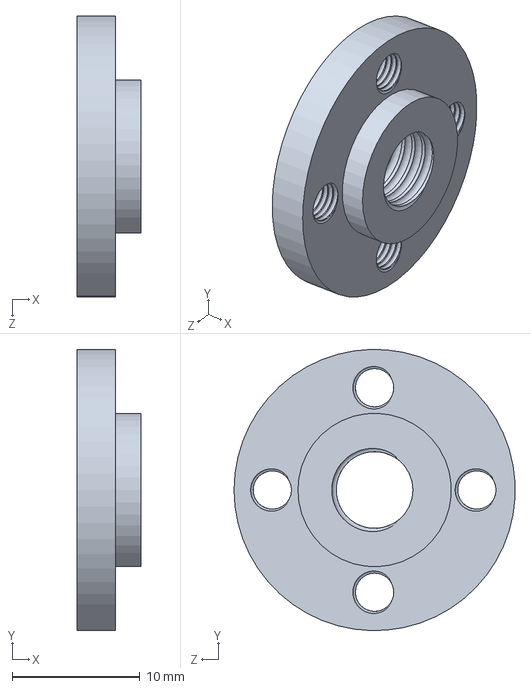
[picture p52: CAD file, 2026-10-14]
模型/第二版建模sw文件/丝杆法兰.SLDPRT
5.00 x 22.0 x 22.0 mm
