Jzhoou/Lymphedema-Massager/模型/第二版建模sw文件/连接杆.SLDPRT

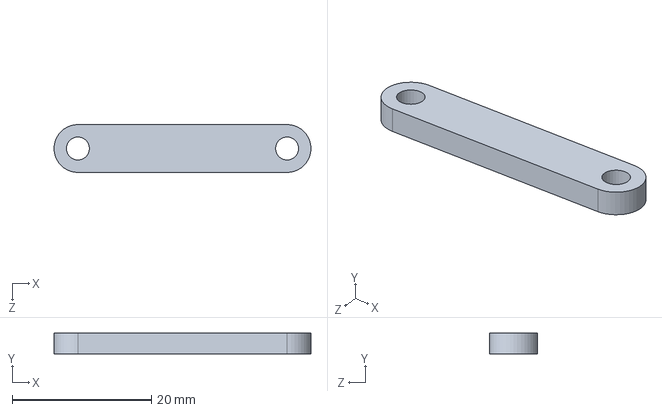
[picture p53: CAD file, 2026-10-14]
模型/第二版建模sw文件/连接杆.SLDPRT
36.9 x 3.00 x 6.87 mm
