Jzhoou/Lymphedema-Massager/模型/第二版建模sw文件/法兰.SLDPRT

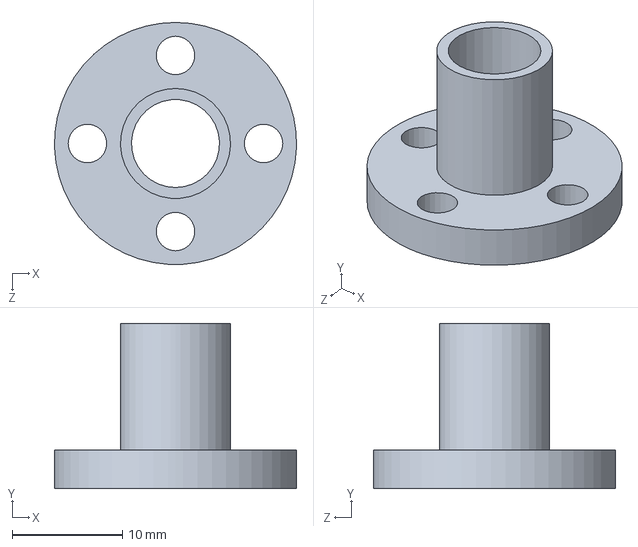
[picture p54: CAD file, 2026-10-14]
模型/第二版建模sw文件/法兰.SLDPRT
22.0 x 15.0 x 22.0 mm
