Jzhoou/Lymphedema-Massager/模型/第二版建模sw文件/光电槽形开关.SLDPRT

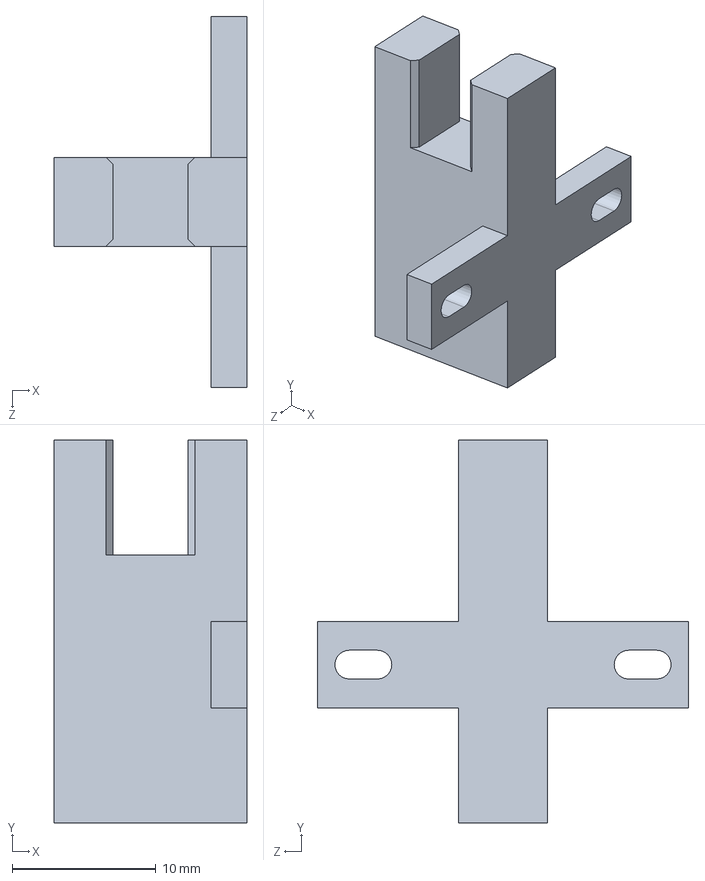
[picture p55: CAD file, 2026-10-14]
模型/第二版建模sw文件/光电槽形开关.SLDPRT
13.4 x 26.6 x 25.8 mm
