Jzhoou/Lymphedema-Massager/模型/第二版建模sw文件/舵机盘.SLDPRT

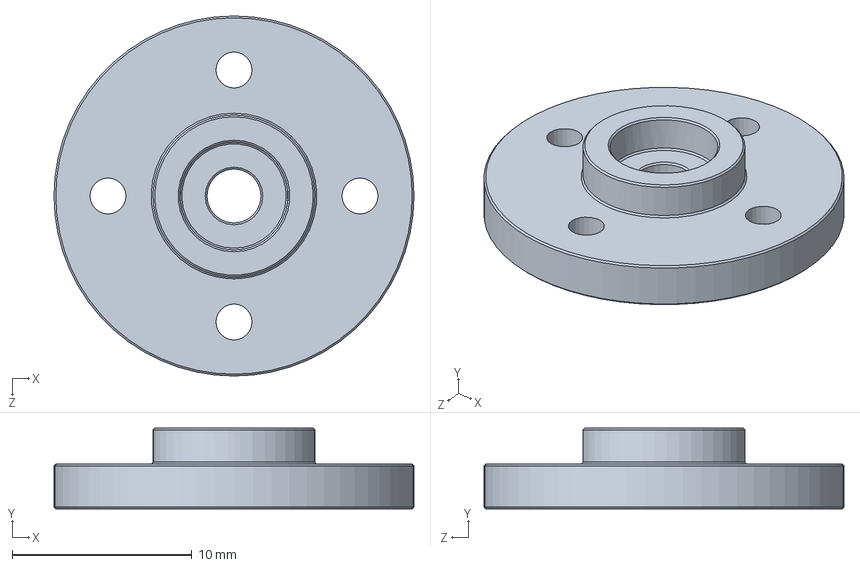
[picture p56: CAD file, 2026-10-14]
模型/第二版建模sw文件/舵机盘.SLDPRT
20.0 x 4.50 x 20.0 mm
