Jzhoou/Lymphedema-Massager/(list of files, cad)

Other CAD files:
模型/第二版建模sw文件/压力/xiabufen6.stp
模型/第二版建模sw文件/压力/柱塞.SLDPRT
模型/第二版建模sw文件/压力/_shangke.stp
模型/第二版建模sw文件/挡片1.SLDPRT
