Jzhoou/Lymphedema-Massager/程序/下位机/main/日志.txt

康复理疗设备嵌入式控制系统 - 开发日志
项目概述
项目名称: 康复理疗设备嵌入式控制系统
硬件平台: BMduino UNO
开发环境: Arduino IDE
版本: v1.0.0
更新日期: 2026-04-20

v1.0.0 - 基础功能集成版本
一、已实现功能模块
1. 步进电机控制模块 (motor_control.cpp/h)
项目	说明
通信接口	Serial3, 115200 bps
控制方式	双电机同步控制 (ID: 0x02, 0x04)
功能函数	To_arm() - 正转伸出 / back() - 反转收回
指令格式	13字节位置控制指令，固定校验和 0x6B
2. 舵机控制模块 (ServoController.cpp/h)
项目	说明
驱动芯片	PCA9685 (I2C地址 0x40)
PWM频率	50Hz
控制通道	6路舵机 (通道 0~5)
功能函数	setAllServos() - 批量设置 / setPulse() - 单路设置
PID控制	框架已搭建，比例控制(P)已实现，积分(I)和微分(D)预留接口
3. 压力采集模块 (MY2901.cpp/h + PressureSensor.cpp/h)
项目	说明
采集芯片	MY2901 (8通道)
通信接口	Serial4, 115200 bps
数据格式	20字节帧，支持BCD/HEX双格式
校准方式	7点分段线性插值
输出范围	0 ~ 2000g
4. 生物电阻抗测量模块 (AD5933.cpp/h)
项目	说明
测量芯片	AD5933
通信接口	I2C1 (SDA1/D18, SCL1/D19)
测量频率	20kHz / 50kHz 双频
校准方式	多次采样平均 (默认10次)
数据处理	冒泡排序去极值滤波
输出参数	阻抗值(Ω) + 相位角(°) + 阻抗比(Z20k/Z50k)
5. OLED显示模块 (DisplayHelper.cpp/h)
项目	说明
显示屏	SSD1306 (128x64)
通信接口	I2C1 (与AD5933共用总线)
显示内容	校准进度 / 测量结果 (双频阻抗值 + 阻抗比)
6. 通信协议模块 (BM53_Protocol.cpp/h)
项目	说明
通信接口	Serial2, 460800 bps
帧格式	帧头 0xAA 0x55 + 长度 + 命令 + 数据 + CRC16 + 帧尾 0x0D
支持命令	心跳、握手、设备信息、治疗控制、参数设置、数据上报等
传输策略	TCP类(可靠) / UDP类(实时) 区分处理
二、系统工作流程 (main.ino)
text
┌─────────────────────────────────────────────────────────────┐
│                        系统初始化                            │
├─────────────────────────────────────────────────────────────┤
│  1. I2C总线初始化 (Wire + Wire1)                             │
│  2. 步进电机初始化 (Serial3)                                 │
│  3. 舵机初始化 (PCA9685) → 归位(237)                         │
│  4. 压力传感器初始化 (Serial4)                                │
│  5. OLED初始化                                               │
│  6. AD5933初始化 → 20kHz校准 → 50kHz校准                     │
│  7. BM53通信协议初始化 (Serial2)                             │
└─────────────────────────────────────────────────────────────┘
                              ↓
┌─────────────────────────────────────────────────────────────┐
│                        主循环运行                            │
├─────────────────────────────────────────────────────────────┤
│  循环周期: 15秒                                              │
│  ┌──────────────┐      ┌──────────────┐                     │
│  │  To_arm阶段                │ → │   Back阶段   │                     │
│  │  电机正转伸出              │      │  电机反转收回 │                     │
│  │  舵机位237                   │      │  舵机位275   │                     │
│  └──────────────┘      └──────────────┘                     │
│         ↓                                                          ↓                             │
│   压力实时采集                         执行生物电阻抗测量                    │
│   PID调节舵机                           (20k+50k双频)                       │
│                                                         OLED显示结果                         │
└─────────────────────────────────────────────────────────────┘
三、已知问题与待办事项
待完善功能
优先级	模块	问题描述
高	通信协议	上位机通信虽已封装，但尚未完善所有指令响应
高	PID控制	框架已搭建，仅实现比例项，积分项和微分项未启用，参数未整定
中	舵机控制	updatePIDControl() 函数调用但参数调优未完成
中	校准功能	校准表 CAL_AD[] 和 CAL_FORCE[] 需根据实际传感器实测数据填写
低	错误处理	部分模块错误后直接 for(;;) 死循环，缺少优雅降级机制

硬件注意事项
项目	说明
I2C地址冲突	AD5933 (0x0D) 和 OLED (0x3C) 共用 I2C1 总线，地址无冲突
串口分配	Serial(调试) / Serial2(通信) / Serial3(电机) / Serial4(压力)
上拉电阻	I2C总线需外接 2.2kΩ~10kΩ 上拉电阻

四、文件清单
文件名	功能描述
main.ino	主程序入口，系统调度
AD5933.cpp/h	生物电阻抗测量驱动
BM53_Protocol.cpp/h	上位机通信协议
config.h	用户配置参数
DisplayHelper.cpp/h	OLED显示辅助
motor_control.cpp/h	步进电机控制
MY2901.cpp/h	压力采集芯片驱动
PressureSensor.cpp/h	压力值转换与校准
ServoController.cpp/h	舵机控制(PCA9685)

五、版本规划
版本	计划内容	预计完成
v1.0.0	基础功能集成（当前版本）	已完成
v1.1.0	上位机通信全部联调 + PID参数整定	待定
v1.2.0	错误处理优化 + 自检功能	待定
v2.0.0	多模式治疗流程 + 数据存储	待定

编制: zzy cjj
审核:zzy cjj
日期: 2026-04-20

康复理疗设备嵌入式控制系统 - 开发日志
项目名称：康复理疗设备嵌入式控制系统硬件平台：BMduino UNO开发环境：Arduino IDE版本：v1.0.1更新日期：2026-04-21
一、版本更新说明
本次版本基于 v1.0.0 基础功能集成版，完成全模块代码落地、通信协议完善、PID 控制优化、系统调度与保护机制增强，实现设备完整闭环运行，可稳定响应上位机指令并执行康复理疗流程。
二、已实现 / 完善功能模块
1. 步进电机控制模块（motor_control.cpp/h）
完成 13 字节固定校验和（0x6B）位置控制指令封装
实现 ID 0x02、0x04 双电机同步正转（To_arm）、反转（back）控制
新增全局广播急停指令，支持所有电机立即停止
串口通信：Serial3，115200bps，指令延时与驱动时序匹配
2. 舵机控制模块（ServoController.cpp/h）
基于 PCA9685（0x40）实现 6 路舵机 PWM 控制，50Hz 标准频率
完成单路 / 批量舵机角度设置、初始归位（237）、安全位置（275）控制
PID 闭环控制完整实现：比例项（KP=2.0）启用，积分 / 微分项预留可扩展
压力反馈实时调节舵机位置，目标压力 50g，输出限幅 200~275
3. 压力采集模块（MY2901.cpp/h + PressureSensor.cpp/h）
MY2901 八通道 AD 采集驱动完整，支持 BCD/HEX 双格式解析，20 字节帧校验
实现 7 点分段线性插值校准，底噪过滤与量程限幅（0~2000g）
批量 AD 转压力值转换，支持多通道并行采集与数据滤波
串口通信：Serial4，115200bps，帧超时保护机制
4. 生物电阻抗测量模块（AD5933.cpp/h）
AD5933 芯片 I2C 驱动完整，支持 20kHz/50kHz 双频测量
实现芯片初始化、复位、频率配置、增益设置、阻抗 / 相位采集
多次采样平均校准（默认 10 次）+ 冒泡排序去极值滤波
输出：阻抗值、相位角、双频阻抗比（Z20k/Z50k），校准失败保护
5. OLED 显示模块（DisplayHelper.cpp/h）
SSD1306（128x64）驱动，I2C1 总线与 AD5933 共用无冲突
校准界面：开始 / 进度 / 成功 / 失败状态可视化
测量界面：双频阻抗与阻抗比放大显示，直观可读
异常界面：测量错误、断连保护提示
6. 通信协议模块（BM53_Protocol.cpp/h）
帧格式：0xAA 0x55 帧头 + 长度 + 命令 + 数据 + CRC16 + 0x0D 帧尾
完善全指令响应：心跳、握手、设备信息、启动 / 停止 / 急停治疗、模式 / 强度 / 时长设置、电机 / 舵机控制
传输策略：TCP 类可靠指令、UDP 类实时数据分离
心跳保活（8s 超时）、CRC 校验、环形缓冲区接收解析
7. 主系统调度（main.ino）
标准化初始化流程：I2C→电机→舵机→压力→OLED→AD5933→通信
15 秒周期闭环运行：伸出（To_arm）→压力采集 + PID→收回（Back）→阻抗测量
治疗流程管控：启动、计时、进度上报、自动结束、手动急停
多级保护：断连 10s 自动停机、治疗超时停机、急停锁死
三、系统工作流程（优化版）
上电初始化 → 双频阻抗自动校准 → 待机等待上位机指令
收到启动指令 → 激活治疗 → 按 15 秒周期循环执行
伸出阶段：电机正转 → 舵机 PID 控压 → 压力实时采集上报
收回阶段：电机反转 → 舵机归位 → 双频阻抗测量 → OLED 显示结果
运行中：高频上报压力 / 电机状态，秒级上报水肿 / 进度数据
停止 / 超时 / 断连 / 急停 → 所有机构复位 → 进入安全状态
四、问题修复与优化
通信协议：完成所有上位机指令解析与应答，支持参数实时修改
PID 控制：启用比例控制，压力反馈稳定，参数匹配理疗场景
校准功能：AD5933 双频校准流程固化，失败自动锁定
错误处理：移除死循环，新增断连保护、超时停机、急停优先级机制
实时性：优化采样间隔、上报频率，减少串口阻塞与数据延迟
硬件适配：I2C 上拉电阻提示、串口资源分配清晰、驱动时序匹配
五、硬件注意事项
I2C1 总线：AD5933（0x0D）+ OLED（0x3C），地址无冲突
串口分配：Serial (调试)、Serial2 (通信)、Serial3 (电机)、Serial4 (压力)
必须外接 2.2kΩ~10kΩ I2C 上拉电阻，保证通信稳定
舵机初始位 237，安全位 275；电机指令固定校验和 0x6B
六、文件清单
main.ino、AD5933.cpp/h、BM53_Protocol.cpp/h、config.h、DisplayHelper.cpp/h、motor_control.cpp/h、MY2901.cpp/h、PressureSensor.cpp/h、ServoController.cpp/h
七、版本规划
v1.0.1：全模块代码实现、指令联调、保护机制完善（当前版本）
v1.1.0：PID 参数自动整定、校准表可视化配置、异常日志存储
v1.2.0：多级自检、故障上报、掉电保护
v2.0.0：多治疗模式、数据本地存储、历史数据查询
编制：zzy cjj审核：zzy cjj日期：2026-04-21

4.26

康复理疗设备嵌入式控制系统 - 开发日志
项目名称：康复理疗设备嵌入式控制系统
硬件平台：BMduino UNO
开发环境：Arduino IDE
版本：v1.0.2
更新日期：2026-04-26

一、版本更新说明

本次版本基于 v1.0.1 完善版，优化 AD5933 生物电阻抗测量模块的校准方式，
将 AD5933_cal_measure 调试模块中的宏定义校准功能融合到主系统中，
实现校准方式的灵活切换，简化生产部署流程。

二、具体修改内容

1. AD5933.h 修改
   新增宏定义校准相关配置：
   - 新增校准系数宏定义（CAL_GAIN_20KHZ、CAL_PHASE_20KHZ、CAL_GAIN_50KHZ、CAL_PHASE_50KHZ）
   - 新增校准方式选择宏（USE_CAL_MACROS）
   - 新增频率定义宏（FREQ_20KHZ、FREQ_50KHZ）

2. main.ino 修改
   优化系统初始化流程中的 AD5933 校准部分：
   - 根据 USE_CAL_MACROS 宏选择校准方式
   - 宏定义为 1：直接使用预定义校准系数，跳过运行时校准，加快启动速度
   - 宏定义为 0：执行原有运行时校准流程，需要连接 470Ω 参考电阻

三、校准方式说明

1. 宏定义校准（USE_CAL_MACROS = 1）
   适用场景：生产环境、批量部署
   优点：上电即可使用，无需人工干预，启动速度快
   要求：校准系数已通过 AD5933_cal_measure 调试模块获取并正确填写

2. 运行时校准（USE_CAL_MACROS = 0）
   适用场景：调试阶段、更换 AD5933 模块后
   优点：可根据实际硬件情况动态调整校准系数
   要求：启动时需连接 470Ω 参考电阻到 AD5933 测量端口

四、版本规划

v1.0.2：AD5933 校准方式优化（当前版本）
v1.1.0：PID 参数自动整定、校准表可视化配置、异常日志存储
v1.2.0：多级自检、故障上报、掉电保护
v2.0.0：多治疗模式、数据本地存储、历史数据查询

编制：zzy cjj
审核：zzy cjj
日期：2026-04-26

4.27

康复理疗设备嵌入式控制系统 - 开发日志
项目名称：康复理疗设备嵌入式控制系统
硬件平台：BMduino UNO
开发环境：Arduino IDE
版本：v1.0.3
更新日期：2026-04-27

一、版本更新说明

本次版本基于 v1.0.2 校准优化版，集成电机回零功能，
在系统初始化结束后自动执行电机回零操作，确保设备每次启动都能回到正确的零点位置，
提高系统的一致性和可靠性。

二、具体修改内容

1. motor_control.h 修改
   新增回零相关配置：
   - 新增限位开关引脚定义（LIMIT_SWITCH_2_PIN、LIMIT_SWITCH_4_PIN）
   - 新增回零速度参数（HOMING_SPEED）
   - 新增电机回零函数声明（motor_homing()）

2. motor_control.cpp 修改
   新增电机回零功能实现：
   - 新增 splitSpeed() 辅助函数，用于速度值拆分
   - 新增 motor_homing() 函数，实现电机回零逻辑
   - 支持两个电机独立回零，带有限位开关状态检测和超时保护
   - 优化回零逻辑：在两个电机都触发限位开关后再执行清零位置操作
   - 在停止电机后添加10毫秒延迟，确保电机完全停止
   - 修改To_arm函数中的脉冲参数，从0x069000调整为0x065000

3. main.ino 修改
   优化系统初始化流程：
   - 在通信协议初始化后、生物电阻抗校准前添加电机回零步骤
   - 确保系统启动时自动执行回零操作
   - 在回零完成后添加10毫秒延迟，确保电机完全停止

三、回零功能说明

1. 回零逻辑
   - 检测限位开关状态：若已在零点（限位开关被遮挡，低电平），直接清零位置
   - 若不在零点，电机以低速（5 RPM）反转向零点运动
   - 触发限位开关后立即停止并清零位置
   - 支持两个电机独立回零，各自检测各自的限位开关

2. 安全保护
   - 回零超时保护：30秒超时后强制停止电机
   - 限位开关状态实时监测，确保回零过程安全可靠
   - 回零完成后自动停止电机并清零位置

3. 硬件要求
   - 限位开关：NPN输出型（无遮挡高电平，遮挡低电平）
   - 连接方式：2号电机限位开关连接D8引脚，4号电机限位开关连接D9引脚

四、版本规划

v1.0.3：电机回零功能集成（当前版本）
v1.1.0：PID 参数自动整定、校准表可视化配置、异常日志存储
v1.2.0：多级自检、故障上报、掉电保护
v2.0.0：多治疗模式、数据本地存储、历史数据查询

编制：zzy cjj
审核：zzy cjj
日期：2026-04-27

康复理疗设备嵌入式控制系统 - 开发日志
项目名称： 康复理疗设备嵌入式控制系统
硬件平台： BMduino UNO
开发环境： Arduino IDE
版本： v1.0.4
更新日期： 2026-04-28

一、版本更新说明
本次版本基于 v1.0.3 电机回零集成版，完成代码架构优化与功能增强，主要包括：
数据上报模块封装：将数据上报逻辑从主程序中独立为 DataReporter 类
治疗状态机封装：新增 TherapyStateMachine 类，实现治疗全生命周期状态管理
通信协议命令扩展：新增暂停/继续治疗、退出急停、电机回零、电机步进（双电机同步）、读取电机位置等命令
电机控制功能增强：新增电机位置读取、单步步进（单/双/同步/异步）、非阻塞响应处理等函数
通过本次重构，主程序 main.ino 代码量减少约 33%，模块职责更加清晰，可维护性和可扩展性显著提升。

二、具体修改内容
1. 新增文件
文件名	功能描述
DataReporter.h/cpp	数据上报模块，封装压力、水肿、电机状态、治疗进度的上报逻辑
TherapyStateMachine.h/cpp	治疗状态机模块，管理 IDLE/RUNNING/PAUSED/EMERGENCY_STOP/COMPLETED 五种状态
2. 通信协议模块（BM53_Protocol.h/cpp）修改
新增 6 个命令码：

命令码	宏定义	值	功能	传输类型
暂停治疗	BM53_CMD_PAUSE_THERAPY	0x16	暂停当前正在执行的治疗	TCP
继续治疗	BM53_CMD_RESUME_THERAPY	0x17	从暂停状态恢复治疗，自动补偿暂停时长	TCP
退出急停	BM53_CMD_EXIT_EME_STOP	0x18	解除紧急停止状态，恢复至空闲	TCP
电机回零	BM53_CMD_MOTOR_HOME	0x33	远程触发电机回零操作	TCP
电机步进	BM53_CMD_MOTOR_STEP	0x34	双电机同步步进控制	TCP
读取位置	BM53_CMD_MOTOR_POSITION	0x35	读取指定电机当前位置脉冲数	TCP
同步更新 _getCmdName() 函数，新增对应命令的中文名称映射。

3. 电机控制模块（motor_control.h/cpp）修改
新增 3 种步进控制函数 + 位置读取函数：

函数名	功能	控制方式
motor_step()	单电机步进	立即启动，不等待同步信号
motor_step_sync() ★	双电机同步步进	先分别设置参数，再发送广播指令同时启动
motor_step_async()	双电机异步步进	各自立即启动，适用于不同参数场景
motor_read_position()	读取电机位置	同步阻塞方式，500ms 超时
motor_read_all_positions()	批量读取所有电机位置	逐个读取，间隔 50ms 避免总线冲突
motor_process_response()	处理电机返回数据	非阻塞方式，需在 loop() 中持续调用
get_last_motor_position()	获取最近读取的位置	配合 motor_process_response() 使用
has_new_position_data()	是否有新位置数据	读取后自动清除标志
同步步进与异步步进对比：

对比项	motor_step_sync()	motor_step_async()
启动方式	广播指令同时启动	各自立即启动
指令标志位	byte[11] = 0x01（等待同步）	byte[11] = 0x00（立即执行）
同步精度	高，严格同步	低，存在先后时序
适用场景	需要双电机严格同步运动	两个电机运动参数不同时
位置读取协议说明：

发送指令：[ID] [0x36] [校验0x6B]（3字节）

返回数据：[ID] [0x36] [位置高字节] [位置中高字节] [位置中低字节] [位置低字节] [校验0x6B]（7字节）

电机步进上位机指令数据格式：

text
帧格式: [0xAA] [0x55] [长度] [0x34] [方向0x01] [数据7字节] [CRC16] [0x0D]

数据负载（7字节）:
  byte[0]     方向: 0x00=伸出(CW), 0x01=收回(CCW)
  byte[1-4]   步数: 4字节无符号长整型（高字节在前）
  byte[5-6]   速度: 2字节无符号整型（高字节在前，单位RPM）
4. 治疗状态机模块（TherapyStateMachine.h/cpp）新增
状态定义与流转图：

text
                   		     ┌──────────┐
          ┌─────────│  PAUSED          │─────────┐
          │ resume 	     └──────────┘           pause                  │
          v                              	                                                              │
    ┌──────────┐          start                   ┌──────────┐           │
    │   IDLE                 │─────────→│ RUNNING          │───┘
    └──────────┘←─────────└──────────┘
          ↑                                 stop                      │
          │                                                               │ time up
          │ exit_eme                                              v
    ┌──────────┐                       ┌──────────┐
    │ EME_STOP │                             │COMPLETED     │
    └──────────┘                      └──────────┘
核心功能：

五种状态：IDLE（空闲）、RUNNING（运行中）、PAUSED（暂停）、EMERGENCY_STOP（急停）、COMPLETED（完成）

状态转换保护：非法状态转换自动拒绝（如急停状态下禁止开始治疗，非运行状态不能暂停）

暂停/恢复机制：支持暂停计时，恢复后自动补偿暂停时长，重新计算结束时间

连接超时保护：断开连接 10 秒后自动停止治疗，通过 updateConnectionStatus() 统一管理

状态变化回调：通过 onStateChange() 注册回调函数，便于各模块响应状态变化

进度计算：根据已用时间和总时长自动计算治疗进度百分比（0-100%）

时间查询接口：getElapsedSeconds() / getRemainingSeconds() / getTotalSeconds()

5. 数据上报模块（DataReporter.h/cpp）新增
上报策略总览：

数据类型	上报间隔	触发条件	传输方式
压力数据	200ms（5Hz）	间隔到达 或 数据变化超过阈值	UDP（实时）
水肿数据	1000ms（1Hz）	间隔到达	UDP（实时）
电机状态	100ms（10Hz）	状态变化触发	UDP（实时）
治疗进度	1000ms（1Hz）	间隔到达	TCP（可靠）
优化特性：

压力数据变化检测：仅在数值变化超过阈值（2g）或归零时上报，减少无效传输

归零检测：传感器松开时主动上报一次零值，确保上位机状态同步

强制上报机制：治疗开始时调用 forceReportAll() 强制上报所有初始状态

上报统计：记录总上报次数 getTotalReports()，便于性能监控

6. 主程序（main.ino）重构
代码量变化：

main.ino 从约 600 行减少至约 400 行，减少约 33%

主要变更：

移除内联的数据上报函数（reportAllPressureData、reportEdemaData、reportProgress、reportMotorStatus）

移除内联的状态管理变量（forceWasNonZero、lastReportedForce、isTherapyActive、emergencyStop 等）

新增 onTherapyStateChange() 回调函数，集中处理状态变化时的硬件动作：

RUNNING → 重置上报模块初始状态

PAUSED/IDLE/EMERGENCY_STOP/COMPLETED → 停止电机、舵机归位至 275

初始化流程（共12步）：

I2C 总线初始化（Wire + Wire1）

步进电机初始化（Serial3）

舵机初始化（PCA9685）→ 归位（275）

压力传感器初始化（Serial4）

OLED 初始化

AD5933 初始化

BM53 通信协议初始化（Serial2）

【新增】治疗状态机初始化 + 回调注册

【新增】数据上报模块初始化

电机回零

双频阻抗校准（20kHz + 50kHz）

初始化定时器

主循环状态机驱动：

状态机更新：therapySM.update() 自动检测超时

暂停状态处理：暂停时不执行电机动作，仅维持通信和数据上报

连接状态监控：统一由状态机的 updateConnectionStatus() 处理断连自动停止逻辑

急停优先级最高：急停状态下仅处理通信，不执行任何硬件动作

三、命令码汇总（完整列表）
命令码	宏定义	值	功能	方向	传输
心跳	BM53_CMD_HEARTBEAT	0x01	心跳保活（8s超时）	双向	TCP
握手	BM53_CMD_HANDSHAKE	0x02	握手确认	上位机→设备	TCP
设备信息	BM53_CMD_DEV_INFO	0x03	设备信息上报	上位机→设备	TCP
开始治疗	BM53_CMD_START_THERAPY	0x10	启动治疗流程	上位机→设备	TCP
停止治疗	BM53_CMD_STOP_THERAPY	0x11	正常停止治疗	上位机→设备	TCP
紧急停止	BM53_CMD_EME_STOP	0x12	紧急停止所有动作	上位机→设备	TCP
设置模式	BM53_CMD_SET_MODE	0x13	设置治疗模式	上位机→设备	TCP
设置强度	BM53_CMD_SET_INTENSITY	0x14	设置治疗强度(0-100%)	上位机→设备	TCP
设置时长	BM53_CMD_SET_DURATION	0x15	设置治疗时长(分钟)	上位机→设备	TCP
暂停治疗	BM53_CMD_PAUSE_THERAPY	0x16	暂停治疗（新增）	上位机→设备	TCP
继续治疗	BM53_CMD_RESUME_THERAPY	0x17	继续治疗（新增）	上位机→设备	TCP
退出急停	BM53_CMD_EXIT_EME_STOP	0x18	退出急停状态（新增）	上位机→设备	TCP
步进电机	BM53_CMD_STEPPER_CTRL	0x30	步进电机控制	上位机→设备	TCP
舵机控制	BM53_CMD_SERVO_CTRL	0x31	舵机角度控制	上位机→设备	TCP
舵机归位	BM53_CMD_SERVO_HOME	0x32	舵机归位至安全位置	上位机→设备	TCP
电机回零	BM53_CMD_MOTOR_HOME	0x33	电机回零（新增）	上位机→设备	TCP
电机步进	BM53_CMD_MOTOR_STEP	0x34	双电机同步步进（新增）	上位机→设备	TCP
读取位置	BM53_CMD_MOTOR_POSITION	0x35	读取电机位置（新增）	双向	TCP
压力数据	BM53_CMD_PRESSURE	0x50	压力传感器数据上报	设备→上位机	UDP
水肿数据	BM53_CMD_EDEMA	0x51	生物电阻抗数据上报	设备→上位机	UDP
电机状态	BM53_CMD_MOTOR_STATUS	0x52	电机运行状态上报	设备→上位机	UDP
治疗进度	BM53_CMD_PROGRESS	0x53	治疗进度上报	设备→上位机	TCP
ACK	BM53_CMD_ACK	0x80	确认响应	设备→上位机	TCP
NAK	BM53_CMD_NAK	0x81	否认响应	设备→上位机	TCP
本次新增命令 6 个（表中加粗项），当前协议共支持 25 个命令码。

四、架构优化总结
对比项	重构前（v1.0.3）	重构后（v1.0.4）
main.ino 代码量	~600 行	~400 行（减少 33%）
源文件数量	10 组	12 组（新增 2 组）
状态管理方式	多个布尔变量（isTherapyActive、emergencyStop）分散管理	统一状态机 TherapyStateMachine
数据上报	4 个独立函数散落在 main.ino 中	封装为 DataReporter 类，变化检测内部实现
暂停/继续功能	不支持	支持，自动补偿暂停时长
电机位置读取	不支持	支持同步/异步两种方式
电机步进	仅支持单电机	支持单电机/双电机同步/双电机异步三种模式
状态变化响应	在 loop 中分散处理	通过回调函数集中处理
可维护性	修改逻辑需改动主程序	独立修改对应模块
可扩展性	添加新功能需大量改动 main	只需扩展对应模块类
五、文件清单（更新后）
文件名	功能描述	版本变化
main.ino	主程序入口，系统调度	重构（减少33%代码量）
AD5933.cpp/h	生物电阻抗测量驱动	无变化
BM53_Protocol.cpp/h	上位机通信协议	新增 6 个命令码
config.h	用户配置参数	无变化
DataReporter.cpp/h	数据上报模块	⭐ 新增
DisplayHelper.cpp/h	OLED 显示辅助	无变化
motor_control.cpp/h	步进电机控制	新增 8 个函数
MY2901.cpp/h	压力采集芯片驱动	无变化
PressureSensor.cpp/h	压力值转换与校准	无变化
ServoController.cpp/h	舵机控制（PCA9685）	无变化
TherapyStateMachine.cpp/h	治疗状态机	⭐ 新增
文件总数：12 组（v1.0.3 为 10 组，新增 2 组）

六、版本规划
版本	计划内容	状态
v1.0.0	基础功能集成	✅ 已完成
v1.0.1	全模块代码实现、指令联调、保护机制完善	✅ 已完成
v1.0.2	AD5933 校准方式优化（宏定义校准）	✅ 已完成
v1.0.3	电机回零功能集成	✅ 已完成
v1.0.4	代码架构重构、状态机封装、命令扩展、电机同步步进	✅ 当前版本
v1.0.5	PID 参数自动整定	📋 待开发

七、硬件注意事项
项目	说明
I2C 地址	AD5933（0x0D）+ OLED（0x3C）共用 I2C1 总线，地址无冲突
串口分配	Serial（调试）/ Serial2（BM53通信，460800bps）/ Serial3（电机，115200bps）/ Serial4（压力，115200bps）
I2C 上拉电阻	必须外接 2.2kΩ~10kΩ，保证通信稳定
舵机安全位	初始归位 275，PID 控制区间 200~275
电机同步指令	校验和固定 0x6B，同步广播指令 {0x00, 0xFF, 0x66, 0x6B}
限位开关	NPN 输出型，2 号电机接 D8，4 号电机接 D9
回零超时	30 秒超时保护，防止限位开关故障导致无限等待

编制： zzy cjj
审核： zzy cjj
日期： 2026-04-28
