Jzhoou/Lymphedema-Massager/下位机/main/config.h

/*
 * ================================================================
 * config.h — 用户配置文件 (优化版)
 * ================================================================
 */

#ifndef CONFIG_H
#define CONFIG_H

// =================================================================
// 硬件配置
// =================================================================

// 使用通道数 (1~8)
#define USE_CHANNELS 6

// 传感器量程 (克)
#define FORCE_MIN 50
#define FORCE_MAX 2000

// 底噪阈值
#define BASELINE_AD 12

// =================================================================
// 滤波配置
// =================================================================

// 滑动平均滤波窗口大小 (建议 3~10)
#define FILTER_SIZE 5

// =================================================================
// 显示配置
// =================================================================

// 串口波特率 (建议 115200 提高传输速度)
#define DEBUG_BAUD 115200

// 输出刷新间隔 (毫秒) - 20Hz = 50ms, 10Hz = 100ms
#define PRINT_INTERVAL 50

// 是否显示原始AD值 (true/false)
#define SHOW_RAW_AD true

// 是否启用统计功能 (true/false)
#define ENABLE_STATS true

// 统计信息显示间隔 (毫秒)
#define STATS_INTERVAL 10000

// =================================================================
// 校准表配置 ★★★ 需要实际测量填写 ★★★
// =================================================================

// 校准点数量（必须与下面数组的实际元素个数一致！）
#define CAL_POINTS 7

// 校准点：AD值（必须从小到大排列）
const uint16_t CAL_AD[] = { 
    10,    // 空载
    300,   // 50g
    900,   // 100g
    1600,  // 200g
    2500,  // 500g
    3000,  // 1000g
    3400   // 2000g
};

// 校准点：对应压力值(克)
const uint16_t CAL_FORCE[] = { 
    0, 
    50, 
    100, 
    200, 
    500, 
    1000, 
    2000 
};

// =================================================================
// 高级配置
// =================================================================

// 是否打印原始十六进制数据 (调试用)
#define PRINT_RAW_HEX false

// ===================================================================
// 注意：请确保 CAL_AD 和 CAL_FORCE 数组的元素个数等于 CAL_POINTS
// 如果不一致，程序会在运行时通过 validateCalibration() 检测
// ===================================================================

#endif // CONFIG_H
