Jzhoou/Lymphedema-Massager/(commit log)

2026-06-22 调整下位机4号舵机pid参数
2026-09-08 docs: correct motor status description and remove local artifacts
2026-09-08 docs: align motor arrival wording with firmware
2026-10-14 Add mechanical CAD models and organize programs under one folder
2026-10-14 Describe mechanical CAD assemblies and component modules in README
